pmusgrave/synth_psoc/README.md

# PSYNTH
A synthesizer using a PSoC 4 L-Series microcontroller.
