pmusgrave/synth_psoc/Hardware/Panel Artwork/path2518.png

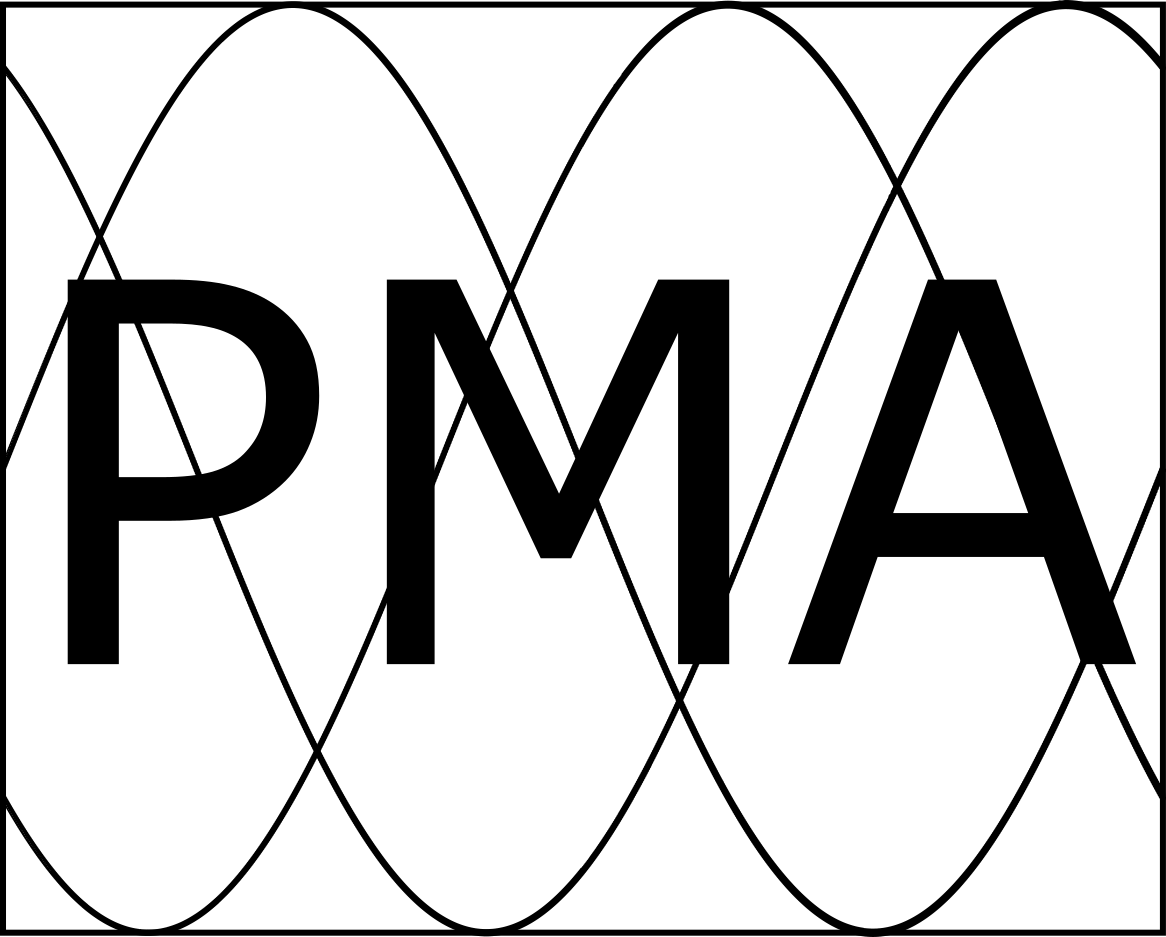
Hardware/Panel Artwork/path2518.png
