pmusgrave/synth_psoc/Hardware/Panel Artwork/Top_panel.png

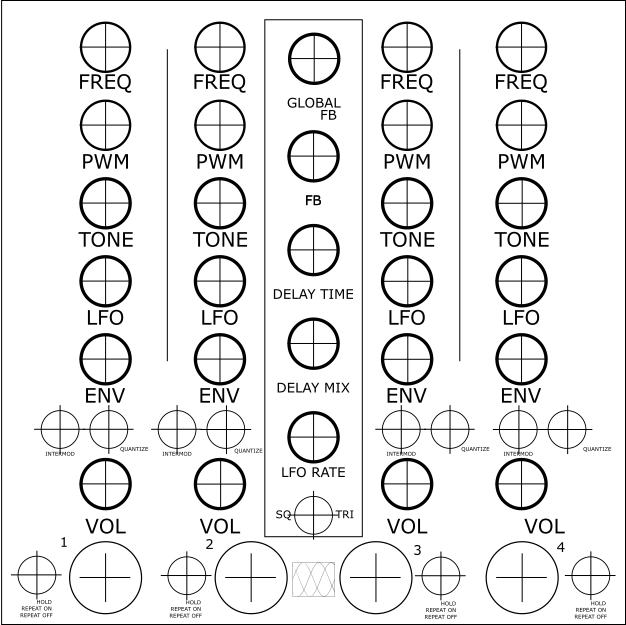
Hardware/Panel Artwork/Top_panel.png
