pmusgrave/synth_psoc/Hardware/Panel Artwork/Top_panel_2019-02-09.png

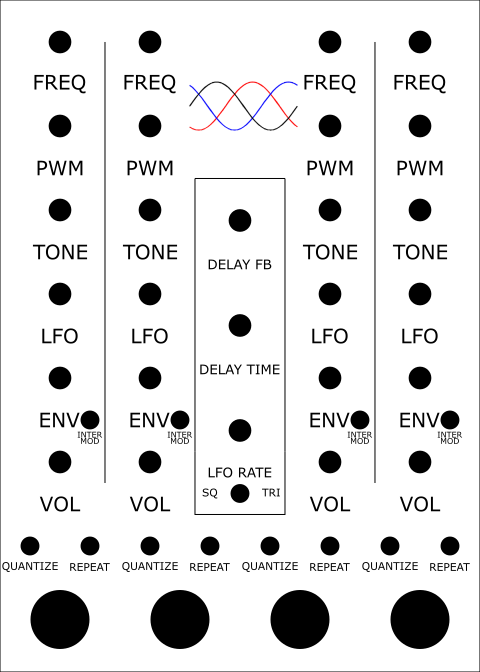
Hardware/Panel Artwork/Top_panel_2019-02-09.png
