pmusgrave/synth_psoc/Hardware/Panel Artwork/Top_panel_2019-02-20.bmp

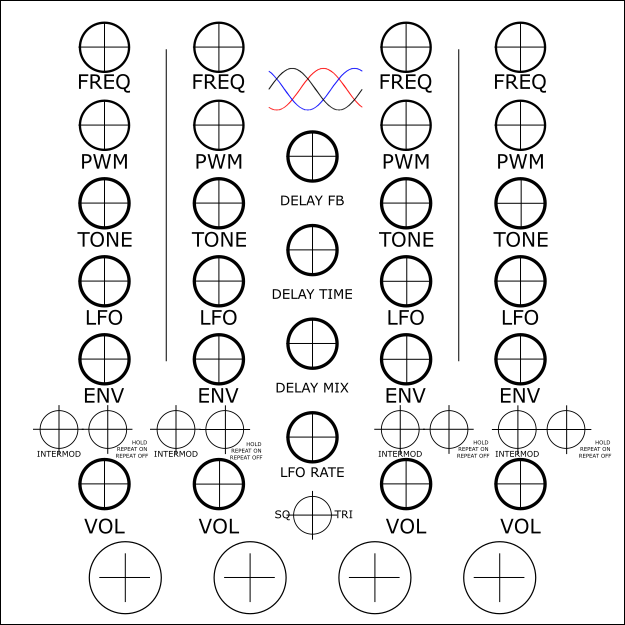
Hardware/Panel Artwork/Top_panel_2019-02-20.bmp
