pmusgrave/synth_psoc/BOM.xlsx

Item | Value | Ref Designator | Description | Manufacturer | Manufacturer P/N | Supplier | Supplier P/N | Quantity | Unit Price | Extended Price
ICs and Semiconductors
 | CY8C4246AZI-L445 | U6 | ARM Microcontrollers - MCU 32KB Flash 4KB SRAM PSoC 4 | Cypress | CY8C4246AZI-L445 | Mouser |  | 1 | $7.78 | $7.78
 | TL074 | U1 U2 U3 U4 U5 | Operational Amplifiers - Op Amps Quad Low Noise JFET | Texas Instruments | TL074CDR | Mouser |  | 5 | $0.57 | $2.85
 | NJM7805 | U7 | Linear Voltage Regulators 5V 1.5A 3 Terminal | JRC | NJM7805FA | Mouser |  | 1 | $0.75 | $0.75
 | PT2399 | U8 | Digital Delay | Princeton | PT2388 | AliExpress |  | 1 | $0.17 | $0.17
 | 4N28 | U9 | High Speed Optocouplers Darlington 100KBd Transistor Output | Lite-On | 6N138 | Mouser |  | 1 | $0.57 | $0.57
 | MMBFJ177 | Q5 Q6 Q7 Q8 | JFET P CH FET SOT-23 | ON Semiconductor | MMBFJ177 | Mouser |  | 4 | $0.40 | $1.60
 | MMBT3904-TP | Q1 Q2 Q3 Q4 Q9 | Bipolar Transistors - BJT NPN Gen Pur SS | Central Semiconductor | 2n3904 | Mouser |  | 5 | $0.40 | $2.00
 | D_Schottky | D1 | Diodes - General Purpose, Power, Switching Schottky Barrier Diode | Panasonic | DB2441700L | Mouser |  | 1 | $0.73 | $0.73
 | BZX84C3V3-T1 | D2 | Zener Diodes 3.3V | Rectron | BZX84C3V3-T1 | Mouser | 583-BZX84C3V3-T1 | 1 | $0.09 | $0.09
 | 1N914 | D3 | Rectifiers 1N914 | Rectron | TCMBD914 | Mouser | 583-TCMBD914 | 1 | $0.04 | $0.04
 |  |  |  |  |  |  |  |  |  | $0.00
 |  |  |  |  |  |  |  |  |  | $0.00
 |  |  |  |  |  |  |  |  |  | $0.00
 |  |  |  |  |  |  |  |  |  | $0.00
Passives |  |  |  |  |  |  |  |  |  | $0.00 | Subtotal | $16.58
 | 22uF | C1 C13 C14 C15 C16 C2 C3 C36 C37 C38 C39 C4 C40 C41 C42 C43 C44 C45 C46 C47 C52 C69 C72 | Aluminum Electrolytic Capacitors - SMD 22UF 35V | Nichicon | UWR1V220MCL1GB | Mouser | 647-UWR1V220MCL1GB | 23 | $0.15 | $3.45
 | 220uF | C17 C24 C25 C26 C27 C28 C29 C30 C31 C70 C71 C73 C74 C75 C76 C77 | Aluminum Electrolytic Capacitors - SMD 35volts 220uF 8x10 20% | Nichicon | UWT1V221MNL1GS | Mouser | 647-UWT1V221MNL1S | 16 | $0.26 | $4.21
 | 0.33uF | C18 | Multilayer Ceramic Capacitors MLCC - SMD/SMT 0805 0.33uF 50volts Y5V +80-20% | Vishay | VJ0805V334ZXAPW1BC | Mouser | 77-VJ0805V334ZXAPBC | 1 | $0.19 | $0.19
 | 0.1uF | C19 C49 C51 C54 C80 C81 C84 C85 C96 | Multilayer Ceramic Capacitors MLCC - SMD/SMT 50V 0.1uF Z5U 0805 -20/+80% | KEMET | C0805C104Z5UAC | Mouser | 80-C0805C104Z5UAC | 9 | $0.05 | $0.44
 | 1uF | C20 C21 C22 C23 | Aluminum Electrolytic Capacitors - SMD 50volts 1uF 4x5.4 20% | Nichicon | UWX1H010MCL1GB | Mouser | 647-UWX1H010MCL1 | 4 | $0.14 | $0.57
 | 1nF | C32 C33 C34 C35 | Multilayer Ceramic Capacitors MLCC - SMD/SMT 1000pF 50volts X7R 10% | Vishay | VJ0805Y102KXAAC | Mouser | 77-VJ0805Y102KXAAC | 4 | $0.12 | $0.48
 | 100pF | C48 C61 C62 C68 | Multilayer Ceramic Capacitors MLCC - SMD/SMT 50V 100pF C0G 0805 5% | KEMET | C0805C101J5GAC7800 | Mouser | 80-C0805C101J5G7800 | 4 | $0.06 | $0.26
 | 10nF | C10 C11 C12 C5 C6 C7 C8 C9 C64 | Multilayer Ceramic Capacitors MLCC - SMD/SMT 50V 0.01uF X7R 0805 5% | KEMET | C0805C103J5RACTU | Mouser | 80-C0805C103J5R | 9 | $0.04 | $0.33
 | 100uF | C50 | Aluminum Electrolytic Capacitors - SMD 100UF 10V | Nichicon | UWR1A101MCL1GB | Mouser | 647-UWR1A101MCL1GB | 1 | $0.19 | $0.19
 | 47uF | C53 | Aluminum Electrolytic Capacitors - SMD 4volts 47uF 4x5.4 20% | Nichicon | UWX0G470MCL1GB | Mouser | 647-UWX0G470MCL1 | 1 | $0.19 | $0.19
 | 560pF | C55 C56 | Multilayer Ceramic Capacitors MLCC - SMD/SMT 560pF 50volts C0G 5% | Vishay | VJ0805A561JXAAC | Mouser | 77-VJ0805A561JXAAC | 2 | $0.13 | $0.26
 | 82nF | C57 C58 | Multilayer Ceramic Capacitors MLCC - SMD/SMT .082uF 50volt 5% X7R | Vishay | VJ0805Y823JXACW1BC | Mouser | 77-VJ0805Y823JXATBC | 2 | $0.20 | $0.40
 | 3900pF | C59 | Multilayer Ceramic Capacitors MLCC - SMD/SMT 3900pF 50volt 5% | Vishay | VJ0805A392JXAAT | Mouser | 77-VJ0805A392JXAAT | 1 | $0.10 | $0.10
 | 3300pF | C60 | Multilayer Ceramic Capacitors MLCC - SMD/SMT 3300 pF 20% | Vishay | VJ0805Y332KXAAC | Mouser | 77-VJ0805Y332KXAAC | 1 | $0.12 | $0.12
 | 4.7uF | C63 C65 | Aluminum Electrolytic Capacitors - SMD 35volts 4.7uF 4x5.4 20% | Nichicon | UWX1V4R7MCL1GB | Mouser | 647-UWX1V4R7MCL1 | 2 | $0.19 | $0.38
 | 10uF | C66 C67 | Aluminum Electrolytic Capacitors - SMD 16volts 10uF 20% | Nichicon | UWX1C100MCL1GB | Mouser | 647-UWX1C100MCL1 | 2 | $0.19 | $0.38
 | 1uF | C78 C79 C83 C86 C88 | Aluminum Electrolytic Capacitors - SMD 50volts 1uF 4x5.4 20% | Nichicon | UWX1H010MCL1GB | Mouser | 647-UWX1H010MCL1 | 5 | $0.14 | $0.71
 | 22pF | C82 C87 C94 C95 | Multilayer Ceramic Capacitors MLCC - SMD/SMT 50V 22pF X8R 0805 10% | KEMET | C0805C220K5HACTU | Mouser | 80-C0805C220K5HACTU | 4 | $0.04 | $0.16
 | 2.2nF | C89 | Multilayer Ceramic Capacitors MLCC - SMD/SMT 50V 2200pF X7R 0805 10% | KEMET | C0805C222K5RAC7025 | Mouser | 80-C0805C222K5RACTM | 1 | $0.05 | $0.05
 | CP1_Small | C90 C91 C92 C93 |  |  |  | Mouser |  | 4 |  | $0.00
 | C_Small | C1 C10 C11 C12 C13 C14 C3 C4 C5 C6 C7 C8 C9 |  |  |  | Mouser |  | 13 |  | $0.00
 | 10uF | C2 |  |  |  | Mouser |  | 1 |  | $0.00
 | 1k | R1 R19 R2 R20 R21 R22 R3 R4 R5 R6 R7 R8 | Thick Film Resistors - SMD 0805 1Kohms 1% AEC-Q200 | Panasonic | ERJ-6ENF1001V | Mouser | 667-ERJ-6ENF1001V | 12 | $0.03 | $0.31
 | 100k | R13 R14 R15 R16 R17 R18 R72 R85 R87 | Thick Film Resistors - SMD 0805 100Kohms 1% AEC-Q200 | Panasonic | ERJ-6ENF1003V | Mouser | 667-ERJ-6ENF1003V | 9 | $0.03 | $0.23
 | 500k | R28 R30 R32 R34 |  |  |  | Mouser |  | 4 |  | $0.00
 | 22k | R35 R36 R37 R38 | Thick Film Resistors - SMD 0805 22Kohms 1% AEC-Q200 | Panasonic | ERJ-6ENF2202V | Mouser | 667-ERJ-6ENF2202V | 4 | $0.05 | $0.18
 | 1MEG | R27 R29 R31 R33 R39 R40 R41 R42 R43 R44 R45 R46 R93 R97 | Thick Film Resistors - SMD 1M 1% | Bourns | CR0805-FX-1004ELF | Mouser | 652-CR0805FX-1004ELF | 14 | $0.01 | $0.13
 | 10k | R100 R103 R51 R52 R53 R54 R56 R58 R59 R60 R63 R64 R66 R67 R68 R69 R73 R74 R75 R78 R79 R81 | Thick Film Resistors - SMD 0805 10Kohms 1% AEC-Q200 | Panasonic | ERJ-6ENF1002V | Mouser | 667-ERJ-6ENF1002V | 22 | $0.03 | $0.57
 | 4.7k | R57 R77 | Thick Film Resistors - SMD 0805 4.7Kohms 1% AEC-Q200 | Panasonic | ERJ-6ENF4701V | Mouser | 667-ERJ-6ENF4701V | 2 | $0.05 | $0.09
 | 15k | R65 R70 | Thick Film Resistors - SMD 0805 15Kohms 1% AEC-Q200 | Panasonic | ERJ-6ENF1502V | Mouser | 667-ERJ-6ENF1502V | 2 | $0.05 | $0.09
 | 5.6k | R71 | Thick Film Resistors - SMD 0805 5.6Kohms 1% AEC-Q200 | Panasonic | ERJ-6ENF5601V | Mouser | 667-ERJ-6ENF5601V | 1 | $0.05 | $0.05
 | 470R | R82 | Thick Film Resistors - SMD 470ohm 1% | Bourns | CR0805-FX-4700ELF | Mouser | 652-CR0805FX-4700ELF | 1 | $0.01 | $0.01
 | 2.2k | R83 | Thick Film Resistors - SMD 2.2K 1% | Bourns | CR0805-FX-2201ELF | Mouser | 652-CR0805FX-2201ELF | 1 | $0.01 | $0.01
 | 860R | R84 | Thick Film Resistors - SMD 0805 866ohms 1% AEC-Q200 | Panasonic | ERJ-6ENF8660V | Mouser | 667-ERJ-6ENF8660V | 1 | $0.05 | $0.05
 | 470k | R10 R11 R12 R23 R24 R25 R26 R47 R48 R49 R50 R55 R61 R62 R76 R80 R86 R88 R89 R9 R90 R91 | Thick Film Resistors - SMD 0805 470Kohms 1% AEC-Q200 | Panasonic | ERJ-6ENF4703V | Mouser | 667-ERJ-6ENF4703V | 22 | $0.03 | $0.57
 | R | R111 R112 R113 R114 R92 R94 |  |  |  | Mouser |  | 6 |  | $0.00
 | 0R | R95 R96 |  |  |  | Mouser |  | 2 |  | $0.00
 | 220R | R101 R102 R98 | Thick Film Resistors - SMD 220ohm 1% | Bourns | CR0805-FX-2200ELF | Mouser | 652-CR0805FX-2200ELF | 3 | $0.01 | $0.03
 | 280R | R99 | Thick Film Resistors - SMD 0805 280ohms 1% AEC-Q200 | Panasonic | ERJ-6ENF2800V | Mouser | 667-ERJ-6ENF2800V | 1 | $0.03 | $0.03
 | POT_TRIM | RV5 RV6 RV7 RV8 | Trimmer Resistors - SMD 3MM 10KOHMS 25% 0.1WATT OPEN FRM | Bourns | TC33X-2-103E | Mouser | 652-TC33X-2-103E | 4 | $0.21 | $0.82
 | R | R1 R10 R11 R12 R13 R14 R15 R16 R17 R18 R19 R2 R20 R21 R22 R23 R24 R25 R3 R4 R5 R6 R7 R8 R9 |  |  |  | Mouser |  | 25 |  | $0.00
 | 20kA | RV1 RV2 RV27 RV3 RV4 RV6 RV7 RV8 RV9 | Potentiometers 20K AUDIO 20% | Bourns | PTV09A-4025F-A203 | Mouser | 652-PTV09A-4025FA203 | 9 | $0.67 | $6.05
 | 20kB | RV10 RV11 RV12 RV13 | Potentiometers 10K LINEAR 20% | Bourns | PTV09A-4025F-B103 | Mouser | 652-PTV09A-4025FB103 | 4 | $0.67 | $2.68
 | POT_DUAL | RV14 RV15 RV16 RV17 | Potentiometers 12MM V/ADJ | ALPS | RK12L12C0A0A | Mouser | 688-RK12L12C0A0A | 4 | $0.70 | $2.80
 | 100kA | RV18 RV19 RV20 RV21 RV22 RV23 RV24 RV25 | Potentiometers 25mm Ins. Kn. Shaft 100,000 Ohms | Bourns | PTV09A-4025U-A104 | Mouser | 652-PTV09A-4025UA104 | 8 | $0.63 | $5.07
 | 50kA | RV26 | Potentiometers 50K AUDIO 20% | Bourns | PTV09A-4225F-A503 | Mouser | 652-PTV09A-4225FA503 | 1 | $0.74 | $0.74
 | 50k | RV28 | ??? |  |  | Mouser |  | 1 |  | $0.00
 | 10kA | RV29 RV5 |  |  |  | Mouser |  | 2 |  | $0.00
 | 16MHz | Y1 | Crystal, 16MHz |  |  | Mouser |  | 1 |  | $0.00
 | 32.768kHz | Y2 | Crystal, 32.768kHz |  |  | Mouser |  | 1 | $0.38 | $0.38
 |  |  |  |  |  |  |  |  |  | $0.00 | Subtotal | $33.76
Mechanical |  |  |  |  |  |  |  |  |  | $0.00
 | ~~-~~ | ~~-~~ | ~~Chassis - Steel 7" x 5" x 2"~~ | ~~Hammond~~ | ~~1441-12BK3~~ | ~~Mouser~~ | ~~546-1441-12BK3~~ | 0 | $13.24 | $0.00
 | ~~-~~ | ~~-~~ | ~~Bottom Plate 7 x 5" 20AWG Steel Black~~ | ~~Hammond~~ | ~~1431-12BK3~~ | ~~Mouser~~ | ~~546-1431-12BK3~~ | 0 | $4.82 | $0.00
 | ~~-~~ | ~~-~~ | Enclosures, Boxes, & Cases Diecast Alum Black 7.38 x 7.38 x 2.48" | Hammond | 1590FBK | Mouser | 546-1590F-BK | 1 | $31.15 | $31.15
 | - | - | Knobs |  |  | AliExpress |  | 29 | $0.39 | $11.31
 | - | - | Toggle Switches SPST ON-OFF-ON |  |  | AliExpress |  | 4 | $0.18 | $0.72
 | - | - | Toggle Switches SPDT ON-ON |  |  | AliExpress |  | 9 | $0.19 | $1.71
 | - | - | PCB, Control Board | JLCPCB |  | JLCPCB |  | 1 | $35.79 | $35.79
 | - | - | PCB, Main Synth Board | JLCPCB |  | JLCPCB |  | 1 | $35.79 | $35.79
 | power | J1 | Headers & Wire Housings 2 POS HEADER | Molex | 22-27-2021 | Mouser | 538-22-27-2021 | 1 | $0.27 | $0.27
 | power | J1 | Headers & Wire Housings CRIMP TERM 22-30 TIN | Molex | 08-50-0114 | Mouser | 538-08-50-0114 | 2 | $0.18 | $0.36
 | power | J1 | Headers & Wire Housings HSG 2P W/RAMP/RIBS | Molex | 22-01-3027 | Mouser | 538-22-01-3027 | 1 | $0.14 | $0.14
 | USB-Cable | J7 | Headers & Wire Housings 4P PIN SIL FEMALE HOUSING | Harwin | M22-3070400 | Mouser | 855-M22-3070400 | 2 | $0.11 | $0.22
 | USB-Board | J7 | Headers & Wire Housings 4 SIL SHRD PIN HDR TIN VERTICAL | Harwin | M22-2200446 | Mouser | 855-M22-2200446 | 2 | $0.24 | $0.48
 | USB-crimp | J7 | Headers & Wire Housings 2MM F/M CRIMP CNTCT 24-30AWG TIN | Harwin | M22-3050046 | Mouser | 855-M22-3050046 | 4 | $0.19 | $0.76
 | USB | J10 | USB Connectors Vertical Plug 2row SMT | JAE Electronics | DX07VN24WA2C1568 | Mouser | 656-DX07VN24WA2C1568 | 1 | $2.38 | $2.38
 | MIDI | J11 | Headers & Wire Housings 02 SIL VERTICAL PIN HEADER TIN | Harwin | M20-9990246 | Mouser | 855-M20-9990246 | 2 | $0.10 | $0.20
 | MIDI Mating connector | J11 | Headers & Wire Housings 2 PIN SIL VERTICAL SOCKET TIN | Harwin | M20-7820246 | Mouser | 855-M20-7820246 | 2 | $0.71 | $1.42
 | Conn_01x05 | J13 J14 J15 J16 | Headers & Wire Housings 5 PIN SIL VERTICAL SOCKET TIN | Harwin | M20-7820546 | Mouser | 855-M20-7820546 | 4 |  | $0.00
 | Audio-Jack-2_Switch | J2 |  |  |  | Mouser |  | 1 |  | $0.00
 | SWD_programming | J3 |  |  |  | Mouser |  | 1 |  | $0.00
 | Conn_01x08 | J4 J5 J11 J4 | Headers & Wire Housings 08 SIL VERTICAL PIN HEADER TIN | Harwin | M20-9990846 | Mouser |  | 4 | $0.29 | $1.16
 | Conn_01x08 | J4 J5 J11 J4 | Headers & Wire Housings | Preci-dip | 310-87-108-41-001101 | Mouser |  | 4 | $0.50 | $2.00
 | Conn_01x03 | J2 J6 | Headers & Wire Housings 03 MODII HDR SRST B/A 100 W/HD | TE Connectivity | 5-146293-3 | Mouser |  | 2 | $0.50 | $1.00
 | Conn_01x03 | J2 J6 | Headers & Wire Housings | Preci-dip | 310-87-103-41-001101 | Mouser |  | 2 | $0.29 | $0.58
 | Conn_02x13_Odd_Even | J1 J3 J8 J9 | Headers & Wire Housings 2X13POS HDR TIN | Amphenol FCI | 67997-426HLF | Mouser |  | 4 |  | $0.00
 | Conn_02x13_Odd_Even | J1 J3 J8 J9 | Headers & Wire Housings 13+13 DIL VERTICAL SOCKET TIN | Harwin | M20-7831346 | Mouser |  | 4 | $2.36 | $9.44
 | DC IN | - | DC Power Connectors DC SOCKET 2.35MM CHASSIS MOUNT | Schurter | 4840.221 | Mouser | 693-4840.221 | 1 | $1.73 | $1.73
 | Conn_01x05 | J10 J7 J8 J9 |  |  |  |  |  | 4 |  | $0.00
 | MIDI Panel Connectors |  | DIN Connectors 5 PIN DIN PANEL MNT | Kobiconn | 161-0005-E | Mouser |  | 2 | $1.65 | $3.30 | Subtotal | $141.91
 |  |  |  |  |  |  |  |  | TOTAL: | $192.25
 |  |  |  |  |  |  |  | U1 U2 U3 U4 U5 | 5 | TL074
 |  |  |  |  |  |  |  | U6 | 1 | CY8C4246AZI-L445
 |  |  |  |  |  |  |  | U7 | 1 | V7805-1000
 |  |  |  |  |  |  |  | U8 | 1 | PT2399
 |  |  |  |  |  |  |  | U9 | 1 | 4N28
 |  |  |  |  |  |  |  | Y1 | 1 | 16MHz
 |  |  |  |  |  |  |  | Y2 | 1 | 32.768kHz
