pmusgrave/synth_psoc/profitability.xlsx

Unit Sales | Profit Per Sale Required to reach target | Target Gross Income | Scenarios | $100.00 | $150.00 | $200.00 | $250.00 | $300.00 | $350.00 | $400.00 | $450.00 | $500.00
1 | $50000.00 | $50000.00 | Profit Per Sale | $100.00 | $150.00 | $200.00 | $250.00 | $300.00 | $350.00 | $400.00 | $450.00 | $500.00
5 | $10000.00 |  | $100.00 | $500.00 | $750.00 | $1000.00 | $1250.00 | $1500.00 | $1750.00 | $2000.00 | $2250.00 | $2500.00
10 | $5000.00 |  | $150.00 | $1000.00 | $1500.00 | $2000.00 | $2500.00 | $3000.00 | $3500.00 | $4000.00 | $4500.00 | $5000.00
15 | $3333.33 |  | $200.00 | $1500.00 | $2250.00 | $3000.00 | $3750.00 | $4500.00 | $5250.00 | $6000.00 | $6750.00 | $7500.00
20 | $2500.00 |  | $250.00 | $2000.00 | $3000.00 | $4000.00 | $5000.00 | $6000.00 | $7000.00 | $8000.00 | $9000.00 | $10000.00
30 | $1666.67 |  | $300.00 | $3000.00 | $4500.00 | $6000.00 | $7500.00 | $9000.00 | $10500.00 | $12000.00 | $13500.00 | $15000.00
40 | $1250.00 |  | $350.00 | $4000.00 | $6000.00 | $8000.00 | $10000.00 | $12000.00 | $14000.00 | $16000.00 | $18000.00 | $20000.00
50 | $1000.00 |  | $400.00 | $5000.00 | $7500.00 | $10000.00 | $12500.00 | $15000.00 | $17500.00 | $20000.00 | $22500.00 | $25000.00
100 | $500.00 |  | $450.00 | $10000.00 | $15000.00 | $20000.00 | $25000.00 | $30000.00 | $35000.00 | $40000.00 | $45000.00 | $50000.00
150 | $333.33 |  | $500.00 | $15000.00 | $22500.00 | $30000.00 | $37500.00 | $45000.00 | $52500.00 | $60000.00 | $67500.00 | $75000.00
200 | $250.00 |  |  | $20000.00 | $30000.00 | $40000.00 | $50000.00 | $60000.00 | $70000.00 | $80000.00 | $90000.00 | $100000.00
250 | $200.00 |  |  | $25000.00 | $37500.00 | $50000.00 | $62500.00 | $75000.00 | $87500.00 | $100000.00 | $112500.00 | $125000.00
300 | $166.67 |  |  | $30000.00 | $45000.00 | $60000.00 | $75000.00 | $90000.00 | $105000.00 | $120000.00 | $135000.00 | $150000.00
350 | $142.86 |  |  | $35000.00 | $52500.00 | $70000.00 | $87500.00 | $105000.00 | $122500.00 | $140000.00 | $157500.00 | $175000.00
400 | $125.00 |  |  | $40000.00 | $60000.00 | $80000.00 | $100000.00 | $120000.00 | $140000.00 | $160000.00 | $180000.00 | $200000.00
450 | $111.11 |  |  | $45000.00 | $67500.00 | $90000.00 | $112500.00 | $135000.00 | $157500.00 | $180000.00 | $202500.00 | $225000.00
500 | $100.00 |  |  | $50000.00 | $75000.00 | $100000.00 | $125000.00 | $150000.00 | $175000.00 | $200000.00 | $225000.00 | $250000.00
550 | $90.91 |  |  | $55000.00 | $82500.00 | $110000.00 | $137500.00 | $165000.00 | $192500.00 | $220000.00 | $247500.00 | $275000.00
600 | $83.33 |  |  | $60000.00 | $90000.00 | $120000.00 | $150000.00 | $180000.00 | $210000.00 | $240000.00 | $270000.00 | $300000.00
650 | $76.92 |  |  | $65000.00 | $97500.00 | $130000.00 | $162500.00 | $195000.00 | $227500.00 | $260000.00 | $292500.00 | $325000.00
700 | $71.43 |  |  | $70000.00 | $105000.00 | $140000.00 | $175000.00 | $210000.00 | $245000.00 | $280000.00 | $315000.00 | $350000.00
750 | $66.67 |  |  | $75000.00 | $112500.00 | $150000.00 | $187500.00 | $225000.00 | $262500.00 | $300000.00 | $337500.00 | $375000.00
800 | $62.50 |  |  | $80000.00 | $120000.00 | $160000.00 | $200000.00 | $240000.00 | $280000.00 | $320000.00 | $360000.00 | $400000.00
850 | $58.82 |  |  | $85000.00 | $127500.00 | $170000.00 | $212500.00 | $255000.00 | $297500.00 | $340000.00 | $382500.00 | $425000.00
900 | $55.56 |  |  | $90000.00 | $135000.00 | $180000.00 | $225000.00 | $270000.00 | $315000.00 | $360000.00 | $405000.00 | $450000.00
950 | $52.63 |  |  | $95000.00 | $142500.00 | $190000.00 | $237500.00 | $285000.00 | $332500.00 | $380000.00 | $427500.00 | $475000.00
1000 | $50.00 |  |  | $100000.00 | $150000.00 | $200000.00 | $250000.00 | $300000.00 | $350000.00 | $400000.00 | $450000.00 | $500000.00
