pmusgrave/synth_psoc/Simulation/P-Channel JFET VGA for envelope generator.asc

C1: cap; 220µ
C2: cap; 220µ
C3: cap; 220µ
J1: pjf; LSJ689B
Q1: npn
R1: res; 100k
R2: res; 10k
R3: res; 1Meg
R4: res; 10k
R5: res; 100k
R6: res; 1Meg
R7: res; 470k
U1: AD795
V1: voltage; PULSE(0 3.3 0 0 0 .001 .002)
V2: voltage; SINE(0 2 5)
V3: voltage; 15
V4: voltage; 15
V5: voltage; 2
V6: voltage; 5
Named nets: 0, 15, -15
.tran 0 1 0 .01
