pmusgrave/synth_psoc/Simulation/bias buffer.asc

C1: cap; 1µ
Q1: npn
R1: res; 47k
R2: res; 15k
R3: res; 1k
V1: voltage; 15
Named nets: 0
.tran 0 0.1 0 0.01
