pmusgrave/synth_psoc/Simulation/LPF.asc

C1: cap; 22µ
C2: cap; 1µ
C3: cap; 22µ
C4: cap; 10n
C5: cap; 22µ
C6: cap; 22µ
C7: cap; 10n
R1: res; 470k
R2: res; 100k
R3: res; 1k
R4: res; 100k
R5: res; 100k
R6: res; 1k
R7: res; 100k
R8: res; 470k
R9: res; 1k
U1: AD795
U2: AD795
V1: voltage; PULSE(0 3.3 0 0 0 0.0001 0.0002); AC 1
V3: voltage; 15
V4: voltage; 15
V5: voltage; PULSE(0 3.3 0 0 0 0.0001 0.0002); AC 1
Named nets: 0, +15V, -15V, VREF
.ac oct 10 1 20k
