pmusgrave/synth_psoc/Simulation/LFO.asc

C1: cap; 22µ
C2: cap; 22µ
C3: cap; 22µ
C4: cap; 1µ
C5: cap; 220µ
D1: zener; 1N750
R1: res; 10k
R2: res; 100k
R3: res; 50k
R4: res; 10k
R5: res; 100k
R6: res; 10k
R7: res; 10k
R8: res; 2.2k
R9: res; 470k
R10: res; 470k
R11: res; 100k
R12: res; 470
R13: res; 860
R15: res; 100k
U1: AD795
U2: AD795
U3: AD795
V3: voltage; 15
V4: voltage; 15
Named nets: 0, +15V, -15V, VREF
.tran 0 0.25 0 0.01
