pmusgrave/synth_psoc/Simulation/summing mixer.asc

C1: cap; 22µ
C2: cap; 100p
C3: cap; 22µ
R1: res; 470k
R2: res; 100k
R3: res; 10k
R4: res; 100k
R5: res; 100k
R6: res; 10k
U2: AD795
V3: voltage; 15
V4: voltage; 15
V5: voltage; PULSE(0 3.3 0 0 0 0.0001 0.0002); AC 1
Named nets: 0, +15V, -15V, VREF
.ac oct 10 1 20k
