pmusgrave/synth_psoc/Simulation/arbitrary phase shifter.asc

C1: cap; 10µ
C2: cap; 33n
Q1: npn
R1: res; 10k
R2: res; 10k
R3: res; 47k
R4: res; 22k
R5: res; 10k
V1: voltage; SINE(0 3 100); AC 1
V2: voltage; 15
Named nets: 0, +v
.ac oct 10 10 20k
