pmusgrave/synth_psoc/Simulation/P-Channel JFET compressor.asc

C1: cap; 220µ
J1: pjf
R1: res; 22k
R2: res; 10k
R3: res; 1Meg
R4: res; 10k
R5: res; 100k
U1: AD795
V1: voltage; PULSE(0 3.3 0 0 0 .001 .002)
V2: voltage; PULSE(0 3.3 0 .3 0 .1 .2)
V3: voltage; 15
V4: voltage; 15
Named nets: 0, 15, -15
.tran 0 1 0 .01
