pmusgrave/synth_psoc/Simulation/PWM_filtering.asc

C1: cap; 220µ
C2: cap; 1µ
C3: cap; 220µ
R1: res; 470k
R2: res; 100k
R3: res; 1k
R4: res; 100k
R5: res; 100k
U2: AD795
V3: voltage; 15
V4: voltage; 15
V5: voltage; PULSE(0 3.3 0 0 0 0.0001 0.0002)
Named nets: 0, +15V, -15V, VREF
.tran 0 .1 0 0.01
