pmusgrave/synth_psoc/Hardware/Synth_Control_Board/control_board.kicad_pcb

## KiCad design Hardware/Synth_Control_Board/control_board.kicad_pcb (2019-03-28)

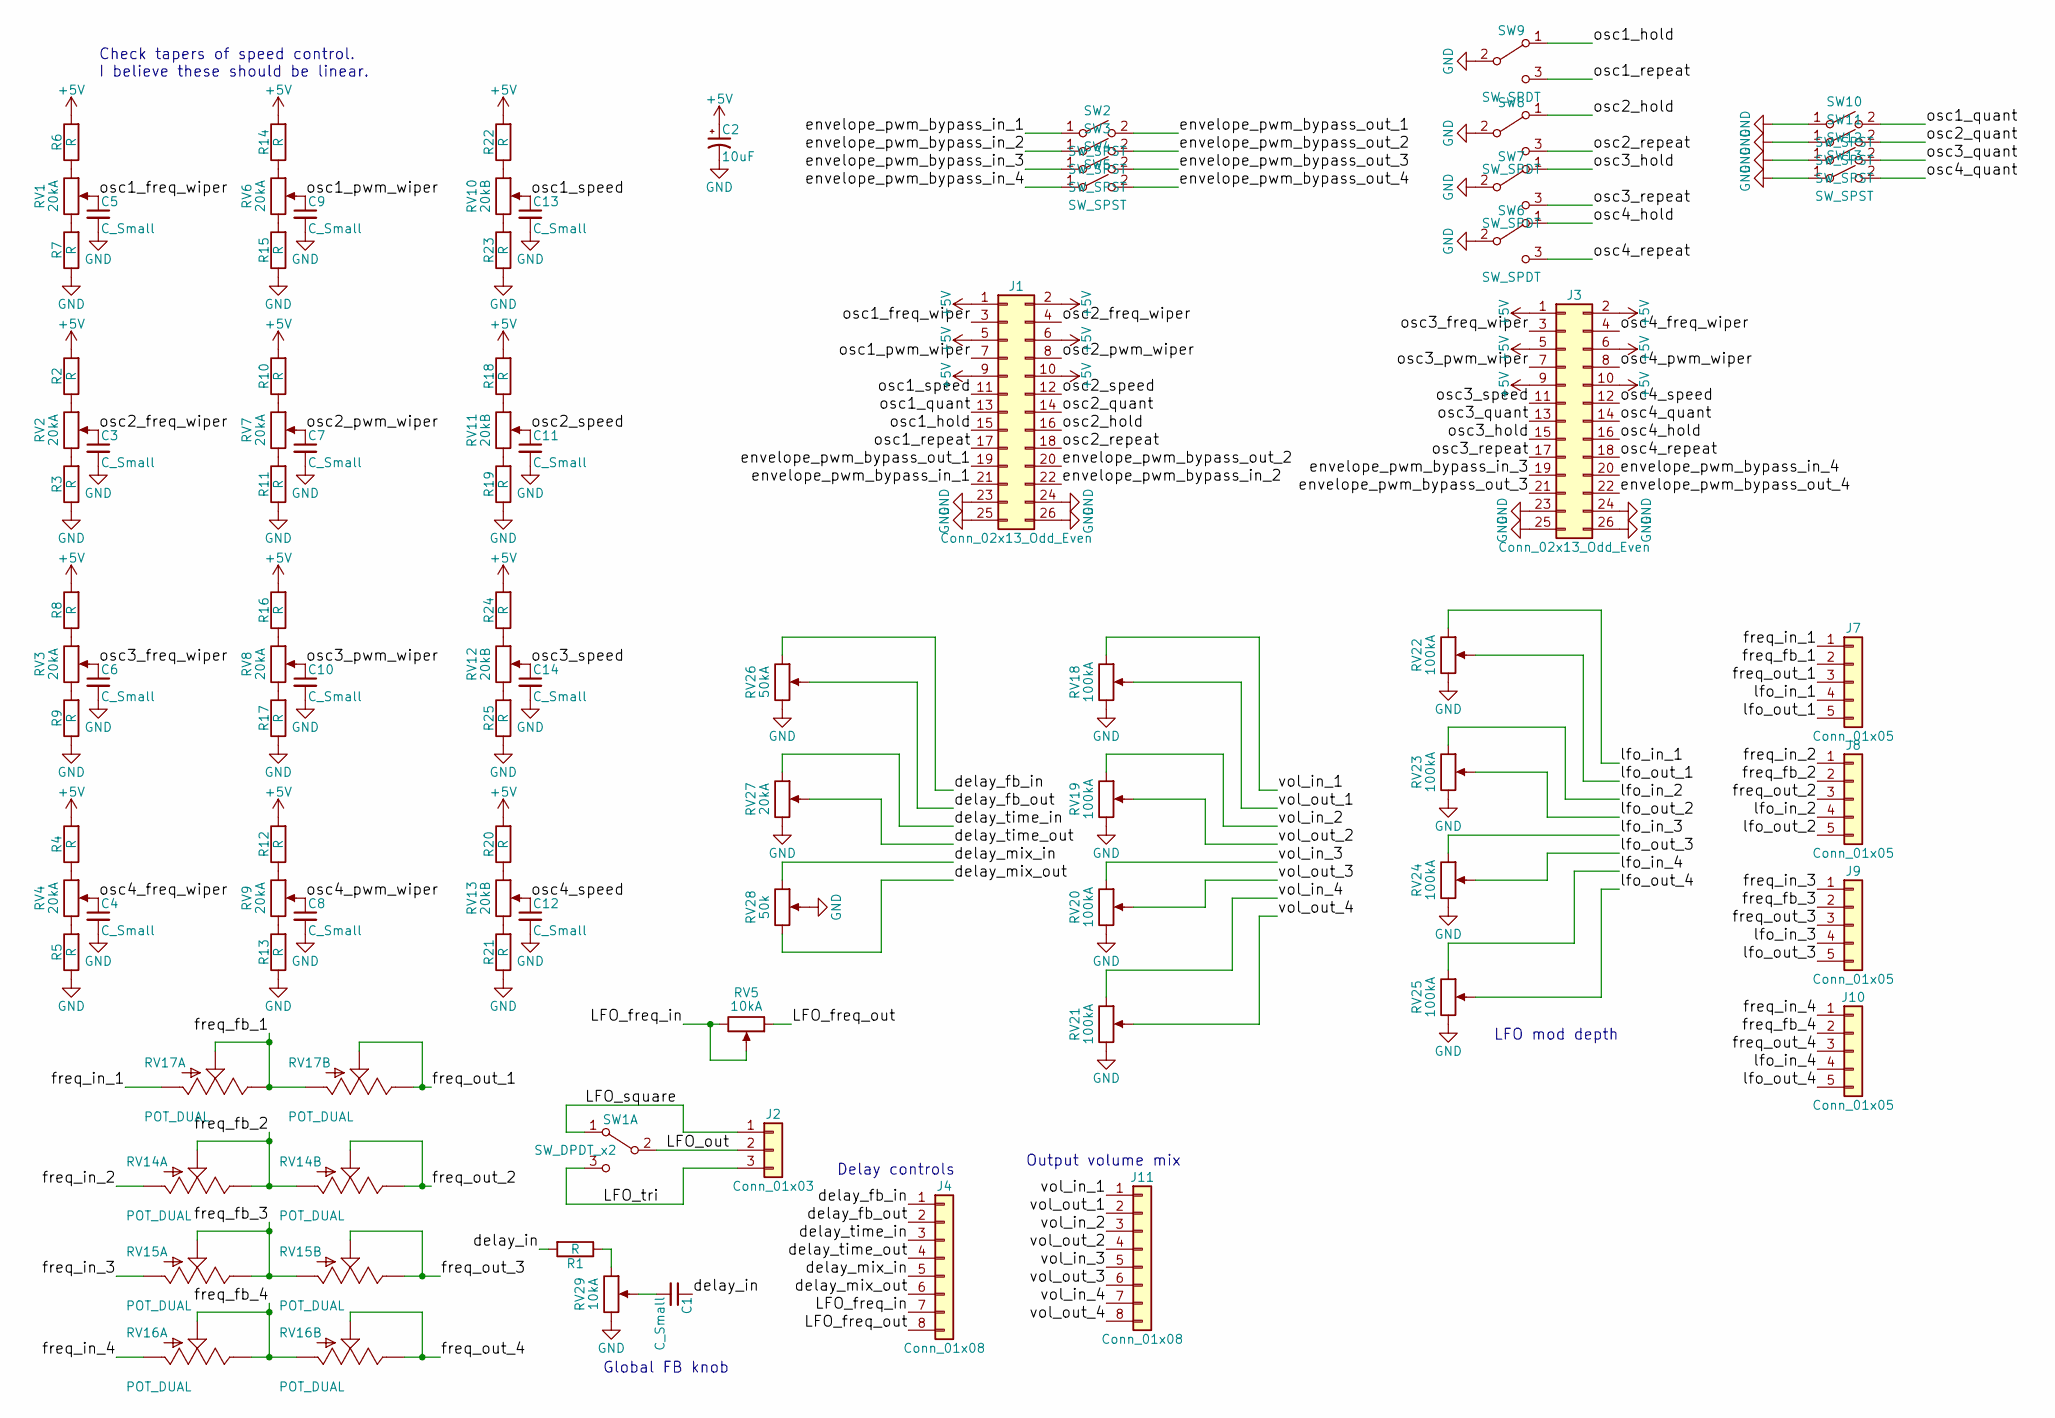
[picture p13: schematic control_board.sch]

Parts:
C1, C3, C4, C5, C6, C7, C8, C9, C10, C11, C12, C13, C14: C_Small; 0805
C2: 10uF; CP_Radial_D8.0mm_P5.00mm
J1, J3: Conn_02x13_Odd_Even; Pin_Header_Straight_2x13_Pitch2.54mm
J2: Conn_01x03; Pin_Header_Straight_1x03_Pitch2.54mm
J4, J11: Conn_01x08; Pin_Header_Straight_1x08_Pitch2.54mm
J7, J8, J9, J10: Conn_01x05; Pin_Header_Straight_1x05_Pitch2.54mm
R1, R2, R3, R4, R5, R6, R7, R8, R9, R10, R11, R12, R13, R14, R15, R16, R17, R18, R19, R20, R21, R22, R23, R24, R25: R; 0805
RV1, RV2, RV3, RV4, RV6, RV7, RV8, RV9, RV27: 20kA; Potentiometer_Bourns_PTV09A-1_Horizontal
RV5, RV29: 10kA; Potentiometer_Bourns_PTV09A-1_Horizontal
RV10, RV11, RV12, RV13: 20kB; Potentiometer_Bourns_PTV09A-1_Horizontal
RV14, RV15, RV16, RV17: POT_DUAL; POT_PANASONIC_DUAL_VERT_KIT
RV18, RV19, RV20, RV21, RV22, RV23, RV24, RV25: 100kA; Potentiometer_Bourns_PTV09A-1_Horizontal
RV26: 50kA; Potentiometer_Bourns_PTV09A-1_Horizontal
RV28: 50k; Potentiometer_Bourns_PTV09A-1_Horizontal
SW1: SW_DPDT_x2; switch_toggle_4.7mm_pitch
SW2, SW3, SW4, SW5, SW10, SW11, SW12, SW13: SW_SPST; switch_toggle_4.7mm_pitch
SW6, SW7, SW8, SW9: SW_SPDT; switch_toggle_4.7mm_pitch

Connections:
+5V: C2.1, J1.1, J1.2, J1.5, J1.6, J1.9, J1.10, J3.1, J3.2, J3.5, J3.6, J3.9, J3.10, R2.2, R4.2, R6.2, R8.2, R10.2, R12.2, R14.2, R16.2, R18.2, R20.2, R22.2, R24.2
/LFO_freq_in: J4.7, RV5.2, RV5.3
/LFO_freq_out: J4.8, RV5.1
/LFO_out: J2.2, SW1.2 (B)
/LFO_square: J2.1, SW1.1 (A)
/LFO_tri: J2.3, SW1.3 (C)
/delay_fb_in: J4.1, RV26.1
/delay_fb_out: J4.2, RV26.2
/delay_in: C1.1, R1.2
/delay_mix_in: J4.5, RV28.1
/delay_mix_out: J4.6, RV28.3
/delay_time_in: J4.3, RV27.1
/delay_time_out: J4.4, RV27.2
/envelope_pwm_bypass_in_1: J1.21, SW2.1 (A)
/envelope_pwm_bypass_in_2: J1.22, SW3.1 (A)
/envelope_pwm_bypass_in_3: J3.19, SW4.1 (A)
/envelope_pwm_bypass_in_4: J3.20, SW5.1 (A)
/envelope_pwm_bypass_out_1: J1.19, SW2.2 (B)
/envelope_pwm_bypass_out_2: J1.20, SW3.2 (B)
/envelope_pwm_bypass_out_3: J3.21, SW4.2 (B)
/envelope_pwm_bypass_out_4: J3.22, SW5.2 (B)
/freq_fb_1: J7.2, RV17.A1 (E), RV17.A2 (S), RV17.B3 (A)
/freq_fb_2: J8.2, RV14.A1 (E), RV14.A2 (S), RV14.B3 (A)
/freq_fb_3: J9.2, RV15.A1 (E), RV15.A2 (S), RV15.B3 (A)
/freq_fb_4: J10.2, RV16.A1 (E), RV16.A2 (S), RV16.B3 (A)
/freq_in_1: J7.1, RV17.A3 (A)
/freq_in_2: J8.1, RV14.A3 (A)
/freq_in_3: J9.1, RV15.A3 (A)
/freq_in_4: J10.1, RV16.A3 (A)
/freq_out_1: J7.3, RV17.B1 (E), RV17.B2 (S)
/freq_out_2: J8.3, RV14.B1 (E), RV14.B2 (S)
/freq_out_3: J9.3, RV15.B1 (E), RV15.B2 (S)
/freq_out_4: J10.3, RV16.B1 (E), RV16.B2 (S)
/lfo_in_1: J7.4, RV22.1
/lfo_in_2: J8.4, RV23.1
/lfo_in_3: J9.4, RV24.1
/lfo_in_4: J10.4, RV25.1
/lfo_out_1: J7.5, RV22.2
/lfo_out_2: J8.5, RV23.2
/lfo_out_3: J9.5, RV24.2
/lfo_out_4: J10.5, RV25.2
/osc1_freq_wiper: C5.1, J1.3, RV1.2
/osc1_hold: J1.15, SW9.1 (A)
/osc1_pwm_wiper: C9.1, J1.7, RV6.2
/osc1_quant: J1.13, SW10.2 (B)
/osc1_repeat: J1.17, SW9.3 (C)
/osc1_speed: C13.1, J1.11, RV10.2
/osc2_freq_wiper: C3.1, J1.4, RV2.2
/osc2_hold: J1.16, SW8.1 (A)
/osc2_pwm_wiper: C7.1, J1.8, RV7.2
/osc2_quant: J1.14, SW11.2 (B)
/osc2_repeat: J1.18, SW8.3 (C)
/osc2_speed: C11.1, J1.12, RV11.2
/osc3_freq_wiper: C6.1, J3.3, RV3.2
/osc3_hold: J3.15, SW7.1 (A)
/osc3_pwm_wiper: C10.1, J3.7, RV8.2
/osc3_quant: J3.13, SW12.2 (B)
/osc3_repeat: J3.17, SW7.3 (C)
/osc3_speed: C14.1, J3.11, RV12.2
/osc4_freq_wiper: C4.1, J3.4, RV4.2
/osc4_hold: J3.16, SW6.1 (A)
/osc4_pwm_wiper: C8.1, J3.8, RV9.2
/osc4_quant: J3.14, SW13.2 (B)
/osc4_repeat: J3.18, SW6.3 (C)
/osc4_speed: C12.1, J3.12, RV13.2
/vol_in_1: J11.1, RV18.1
/vol_in_2: J11.3, RV19.1
/vol_in_3: J11.5, RV20.1
/vol_in_4: J11.7, RV21.1
/vol_out_1: J11.2, RV18.2
/vol_out_2: J11.4, RV19.2
/vol_out_3: J11.6, RV20.2
/vol_out_4: J11.8, RV21.2
GND: C2.2, C3.2, C4.2, C5.2, C6.2, C7.2, C8.2, C9.2, C10.2, C11.2, C12.2, C13.2, C14.2, J1.23, J1.24, J1.25, J1.26, J3.23, J3.24, J3.25, J3.26, R3.1, R5.1, R7.1, R9.1, R11.1, R13.1, R15.1, R17.1, R19.1, R21.1, R23.1, R25.1, RV18.3, RV19.3, RV20.3, RV21.3, RV22.3, RV23.3, RV24.3, RV25.3, RV26.3, RV27.3, RV28.2, RV29.3, SW6.2 (B), SW7.2 (B), SW8.2 (B), SW9.2 (B), SW10.1 (A), SW11.1 (A), SW12.1 (A), SW13.1 (A)
unnamed: C1.2, RV29.2
unnamed: R1.1, RV29.1
unnamed: R2.1, RV2.1
unnamed: R3.2, RV2.3
unnamed: R4.1, RV4.1
unnamed: R5.2, RV4.3
unnamed: R6.1, RV1.1
unnamed: R7.2, RV1.3
unnamed: R8.1, RV3.1
unnamed: R9.2, RV3.3
unnamed: R10.1, RV7.1
unnamed: R11.2, RV7.3
unnamed: R12.1, RV9.1
unnamed: R13.2, RV9.3
unnamed: R14.1, RV6.1
unnamed: R15.2, RV6.3
unnamed: R16.1, RV8.1
unnamed: R17.2, RV8.3
unnamed: R18.1, RV11.1
unnamed: R19.2, RV11.3
unnamed: R20.1, RV13.1
unnamed: R21.2, RV13.3
unnamed: R22.1, RV10.1
unnamed: R23.2, RV10.3
unnamed: R24.1, RV12.1
unnamed: R25.2, RV12.3

Notes on the sheet:
Check tapers of speed control. I believe these should be linear.
Output volume mix
LFO mod depth
Delay controls
Global FB knob

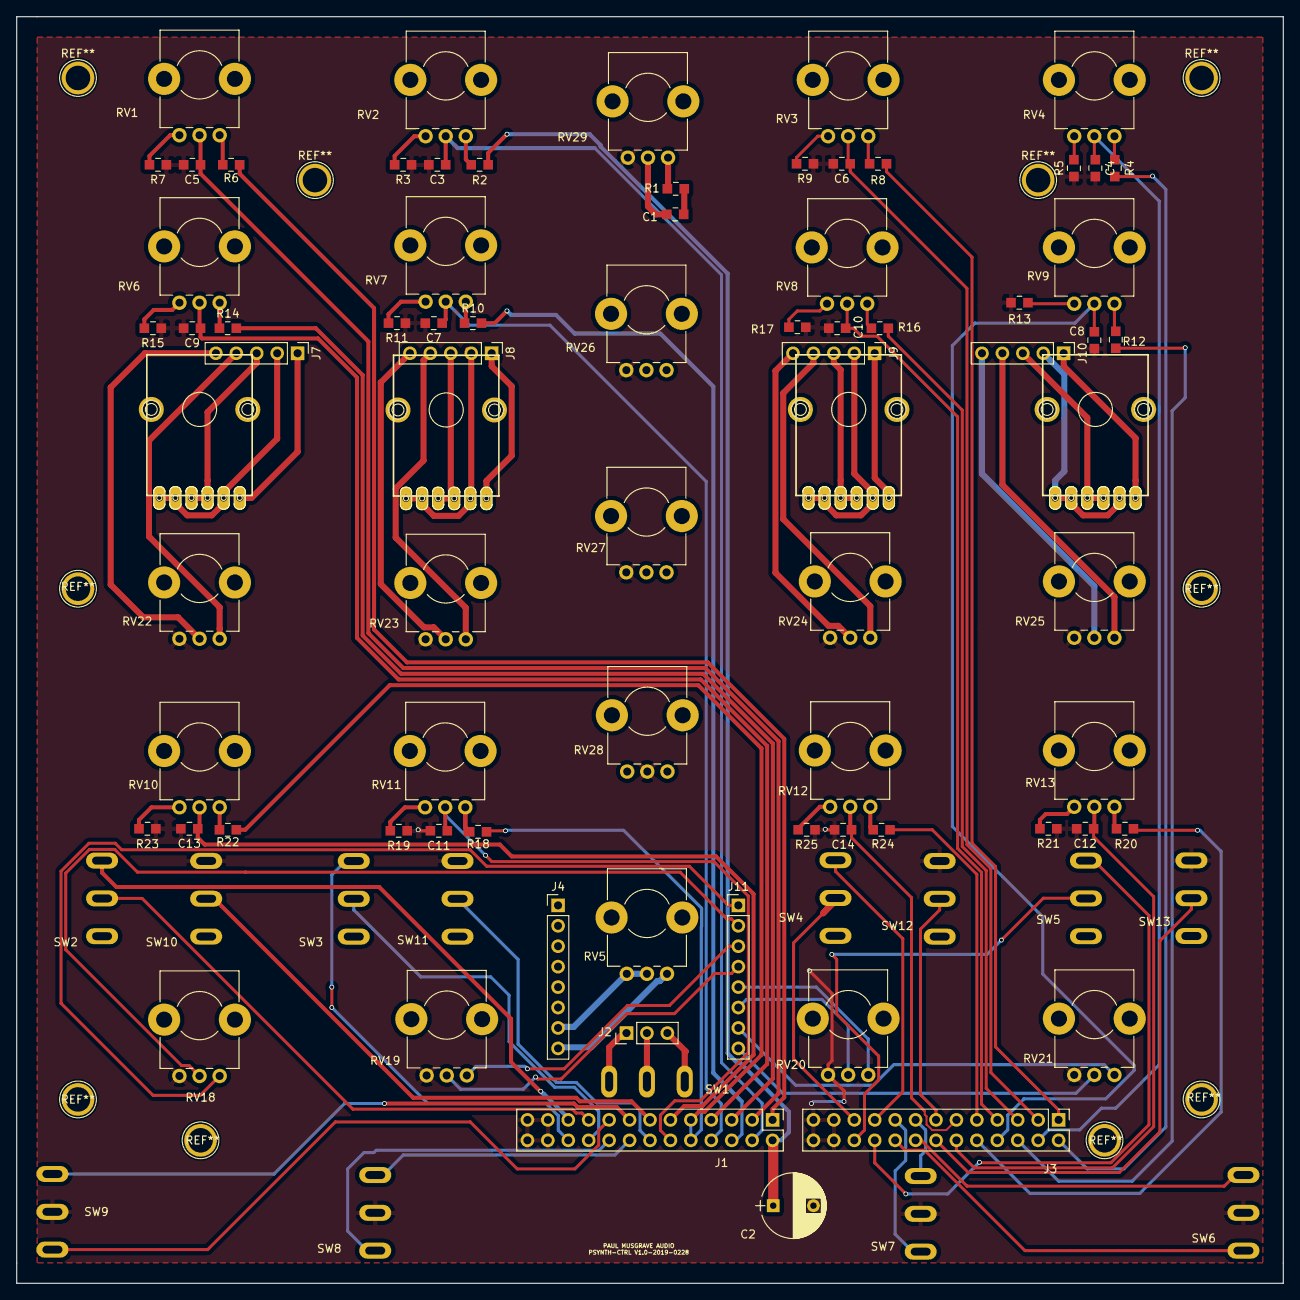
[picture p14: board control_board.kicad_pcb from above]

Board: 2 copper layers, 157.5 x 157.5 mm, 90 parts (0 on the bottom side), 100 nets.
