pmusgrave/synth_psoc/Hardware/Synth_Engine/synth_psoc.kicad_pcb

## KiCad design Hardware/Synth_Engine/synth_psoc.kicad_pcb (2019-03-01)

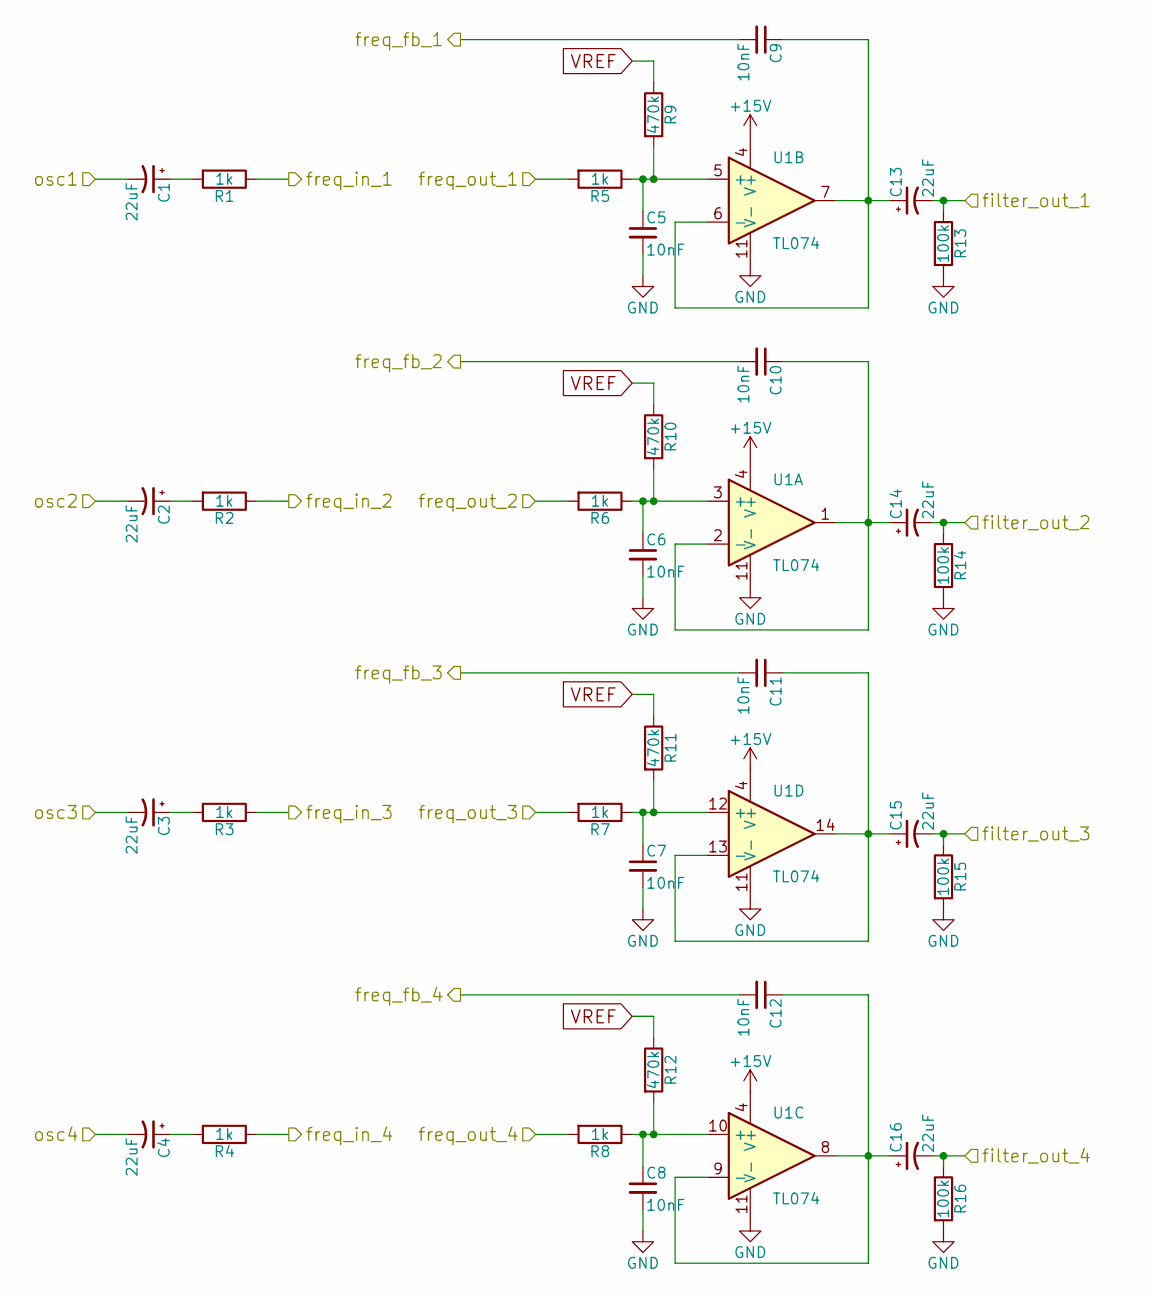
[picture p15: schematic vcf.sch]

Parts:
C1, C2, C3, C4, C13, C14, C15, C16: 22uF; CP_Elec_5x5.7
C5, C6, C7, C8, C9, C10, C11, C12: 10nF; 0805
R1, R2, R3, R4, R5, R6, R7, R8: 1k; 0805
R9, R10, R11, R12: 470k; 0805
R13, R14, R15, R16: 100k; 0805
U1: TL074; SOIC-14_W3.9mm

Connections:
+15V: U1.4 (V+); also elsewhere on the board
/Connectors/freq_fb_1: C9.2; also elsewhere on the board
/Connectors/freq_fb_2: C10.2; also elsewhere on the board
/Connectors/freq_fb_3: C11.2; also elsewhere on the board
/Connectors/freq_fb_4: C12.2; also elsewhere on the board
/Connectors/freq_in_1: R1.1; also elsewhere on the board
/Connectors/freq_in_2: R2.1; also elsewhere on the board
/Connectors/freq_in_3: R3.1; also elsewhere on the board
/Connectors/freq_in_4: R4.1; also elsewhere on the board
/Connectors/freq_out_1: R5.2; also elsewhere on the board
/Connectors/freq_out_2: R6.2; also elsewhere on the board
/Connectors/freq_out_3: R7.2; also elsewhere on the board
/Connectors/freq_out_4: R8.2; also elsewhere on the board
/Filters/filter_out_1: C13.2, R13.1; also elsewhere on the board
/Filters/filter_out_2: C14.2, R14.1; also elsewhere on the board
/Filters/filter_out_3: C15.2, R15.1; also elsewhere on the board
/Filters/filter_out_4: C16.2, R16.1; also elsewhere on the board
/Filters/osc1: C1.2; also elsewhere on the board
/Filters/osc2: C2.2; also elsewhere on the board
/Filters/osc3: C3.2; also elsewhere on the board
/Filters/osc4: C4.2; also elsewhere on the board
GND: C5.2, C6.2, C7.2, C8.2, R13.2, R14.2, R15.2, R16.2, U1.11 (V-); also elsewhere on the board
unnamed: C1.1, R1.2
unnamed: C2.1, R2.2
unnamed: C3.1, R3.2
unnamed: C4.1, R4.2
unnamed: C5.1, R5.1, R9.2, U1.5 (+)
unnamed: C6.1, R6.1, R10.2, U1.3 (+)
unnamed: C7.1, R7.1, R11.2, U1.12 (+)
unnamed: C8.1, R8.1, R12.2, U1.10 (+)
unnamed: C10.1, C14.1, U1.1, U1.2 (-)
unnamed: C11.1, C15.1, U1.13 (-), U1.14
unnamed: C12.1, C16.1, U1.8, U1.9 (-)
unnamed: C9.1, C13.1, U1.6 (-), U1.7
VREF: R9.1, R10.1, R11.1, R12.1; also elsewhere on the board

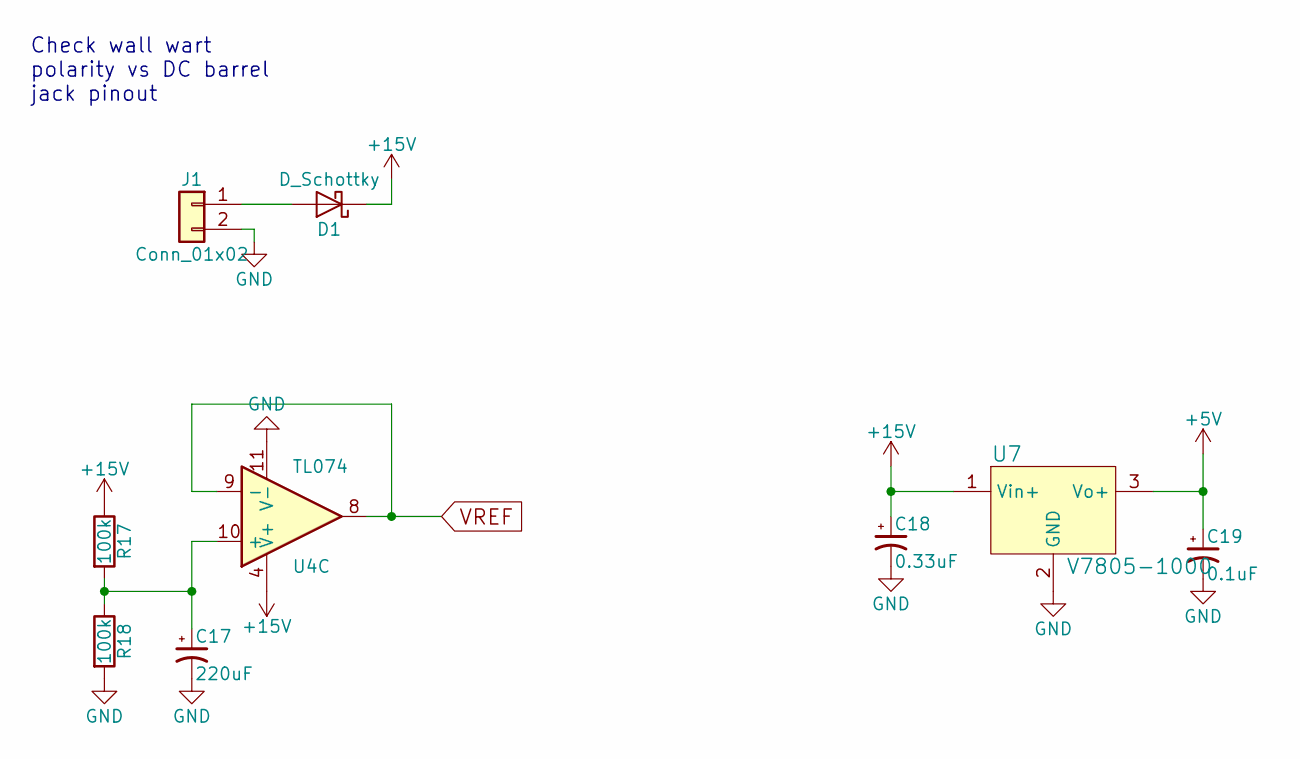
[picture p16: schematic power.sch]

Parts:
C17: 220uF; CP_Elec_8x10
C18: 0.33uF; 0805
C19: 0.1uF; 0805
D1: D_Schottky; D_SMB
J1: Conn_01x02; Pin_Header_Straight_1x02_Pitch2.00mm
R17, R18: 100k; 0805
U4: TL074; SOIC-14_W3.9mm
U7: V7805-1000; 3-SIP_Module_V7805-1000; MPN V7805-1000; Digi-Key_PN 102-1715-ND

Connections:
+5V: C19.1, U7.3 (Vo+); also elsewhere on the board
+15V: C18.1, D1.1 (K), R17.1, U4.4 (V+), U7.1 (Vin+); also elsewhere on the board
GND: C17.2, C18.2, C19.2, J1.2, R18.2, U4.11 (V-), U7.2 (GND); also elsewhere on the board
unnamed: C17.1, R17.2, R18.1, U4.10 (+)
unnamed: D1.2 (A), J1.1
VREF: U4.8, U4.9 (-); also elsewhere on the board

Notes on the sheet:
Check wall wart polarity vs DC barrel jack pinout

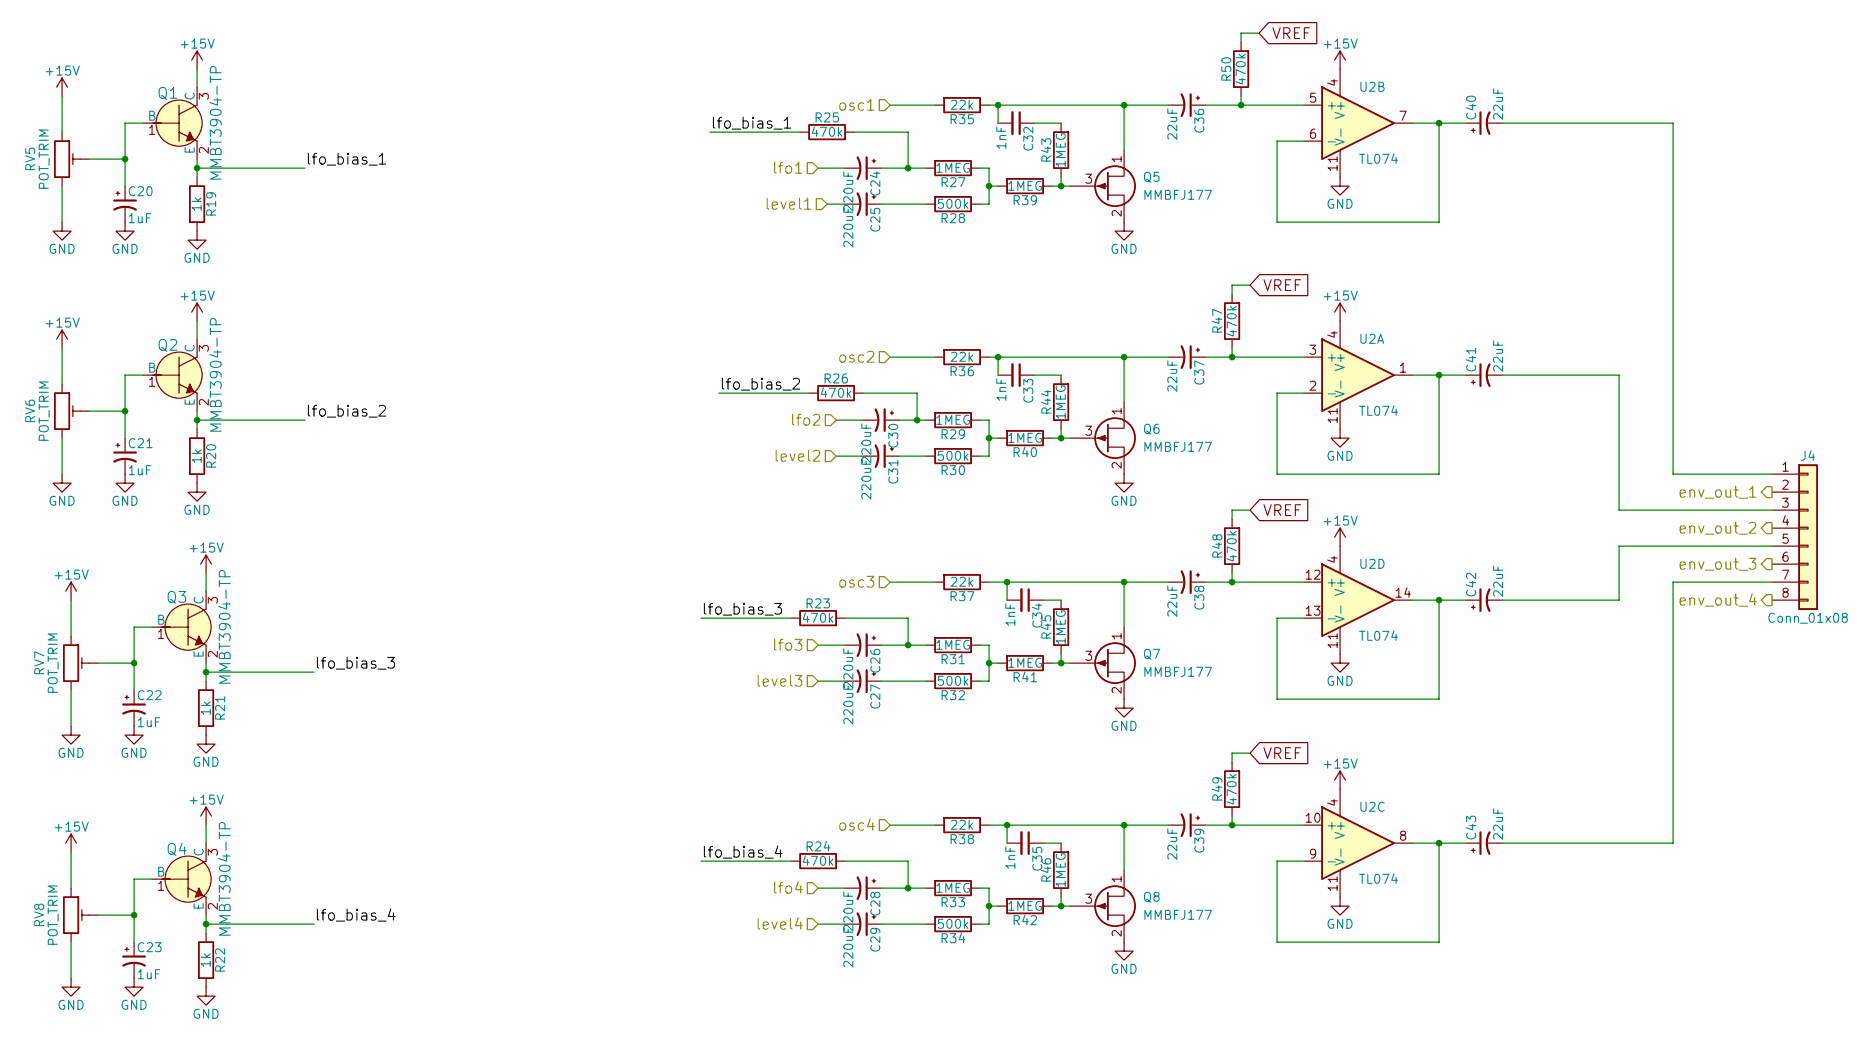
[picture p17: schematic vca.sch]

Parts:
C20, C21, C22, C23: 1uF; CP_Elec_4x4.5
C24, C25, C26, C27, C28, C29, C30, C31: 220uF; CP_Elec_8x10
C32, C33, C34, C35: 1nF; 0805
C36, C37, C38, C39, C40, C41, C42, C43: 22uF; CP_Elec_5x5.7
J4: Conn_01x08; Pin_Header_Straight_1x08_Pitch2.54mm
Q1, Q2, Q3, Q4: MMBT3904-TP; SOT-23-3; MPN MMBT3904-TP; Digi-Key_PN MMBT3904TPMSCT-ND
Q5, Q6, Q7, Q8: MMBFJ177; SOT-23-3
R19, R20, R21, R22: 1k; 0805
R23, R24, R25, R26, R47, R48, R49, R50: 470k; 0805
R27, R29, R31, R33, R39, R40, R41, R42, R43, R44, R45, R46: 1MEG; 0805
R28, R30, R32, R34: 500k; 0805
R35, R36, R37, R38: 22k; 0805
RV5, RV6, RV7, RV8: POT_TRIM; Potentiometer_Trimmer-EVM3E
U2: TL074; SOIC-14_W3.9mm

Connections:
+15V: Q1.3 (C), Q2.3 (C), Q3.3 (C), Q4.3 (C), RV5.1, RV6.1, RV7.1, RV8.1, U2.4 (V+); also elsewhere on the board
/Envelope/env_out_1: J4.2; also elsewhere on the board
/Envelope/env_out_2: J4.4; also elsewhere on the board
/Envelope/env_out_3: J4.6; also elsewhere on the board
/Envelope/env_out_4: J4.8; also elsewhere on the board
/Envelope/lfo_bias_1: Q1.2 (E), R19.1, R25.1
/Envelope/lfo_bias_2: Q2.2 (E), R20.1, R26.1
/Envelope/lfo_bias_3: Q3.2 (E), R21.1, R23.1
/Envelope/lfo_bias_4: Q4.2 (E), R22.1, R24.1
/Filters/filter_out_1: R35.2; also elsewhere on the board
/Filters/filter_out_2: R36.2; also elsewhere on the board
/Filters/filter_out_3: R37.2; also elsewhere on the board
/Filters/filter_out_4: R38.2; also elsewhere on the board
/Microcontroller/envelope_pwm_1: C25.2; also elsewhere on the board
/Microcontroller/envelope_pwm_2: C31.2; also elsewhere on the board
/Microcontroller/envelope_pwm_3: C27.2; also elsewhere on the board
/Microcontroller/envelope_pwm_4: C29.2; also elsewhere on the board
/lfo_out_1: C24.2; also elsewhere on the board
/lfo_out_2: C30.2; also elsewhere on the board
/lfo_out_3: C26.2; also elsewhere on the board
/lfo_out_4: C28.2; also elsewhere on the board
GND: C20.2, C21.2, C22.2, C23.2, Q5.2 (S), Q6.2 (S), Q7.2 (S), Q8.2 (S), R19.2, R20.2, R21.2, R22.2, RV5.3, RV6.3, RV7.3, RV8.3, U2.11 (V-); also elsewhere on the board
unnamed: C20.1, Q1.1 (B), RV5.2
unnamed: C21.1, Q2.1 (B), RV6.2
unnamed: C22.1, Q3.1 (B), RV7.2
unnamed: C23.1, Q4.1 (B), RV8.2
unnamed: C24.1, R25.2, R27.2
unnamed: C25.1, R28.2
unnamed: C26.1, R23.2, R31.2
unnamed: C27.1, R32.2
unnamed: C28.1, R24.2, R33.2
unnamed: C29.1, R34.2
unnamed: C30.1, R26.2, R29.2
unnamed: C31.1, R30.2
unnamed: C32.1, R43.2
unnamed: C32.2, C36.2, Q5.1 (D), R35.1
unnamed: C33.1, R44.2
unnamed: C33.2, C37.2, Q6.1 (D), R36.1
unnamed: C34.1, R45.2
unnamed: C34.2, C38.2, Q7.1 (D), R37.1
unnamed: C35.1, R46.2
unnamed: C35.2, C39.2, Q8.1 (D), R38.1
unnamed: C36.1, R50.1, U2.5 (+)
unnamed: C37.1, R47.1, U2.3 (+)
unnamed: C38.1, R48.1, U2.12 (+)
unnamed: C39.1, R49.1, U2.10 (+)
unnamed: C40.1, U2.6 (-), U2.7
unnamed: C40.2, J4.1
unnamed: C41.1, U2.1, U2.2 (-)
unnamed: C41.2, J4.3
unnamed: C42.1, U2.13 (-), U2.14
unnamed: C42.2, J4.5
unnamed: C43.1, U2.8, U2.9 (-)
unnamed: C43.2, J4.7
unnamed: Q5.3 (G), R39.1, R43.1
unnamed: Q6.3 (G), R40.1, R44.1
unnamed: Q7.3 (G), R41.1, R45.1
unnamed: Q8.3 (G), R42.1, R46.1
unnamed: R27.1, R28.1, R39.2
unnamed: R29.1, R30.1, R40.2
unnamed: R31.1, R32.1, R41.2
unnamed: R33.1, R34.1, R42.2
VREF: R47.2, R48.2, R49.2, R50.2; also elsewhere on the board

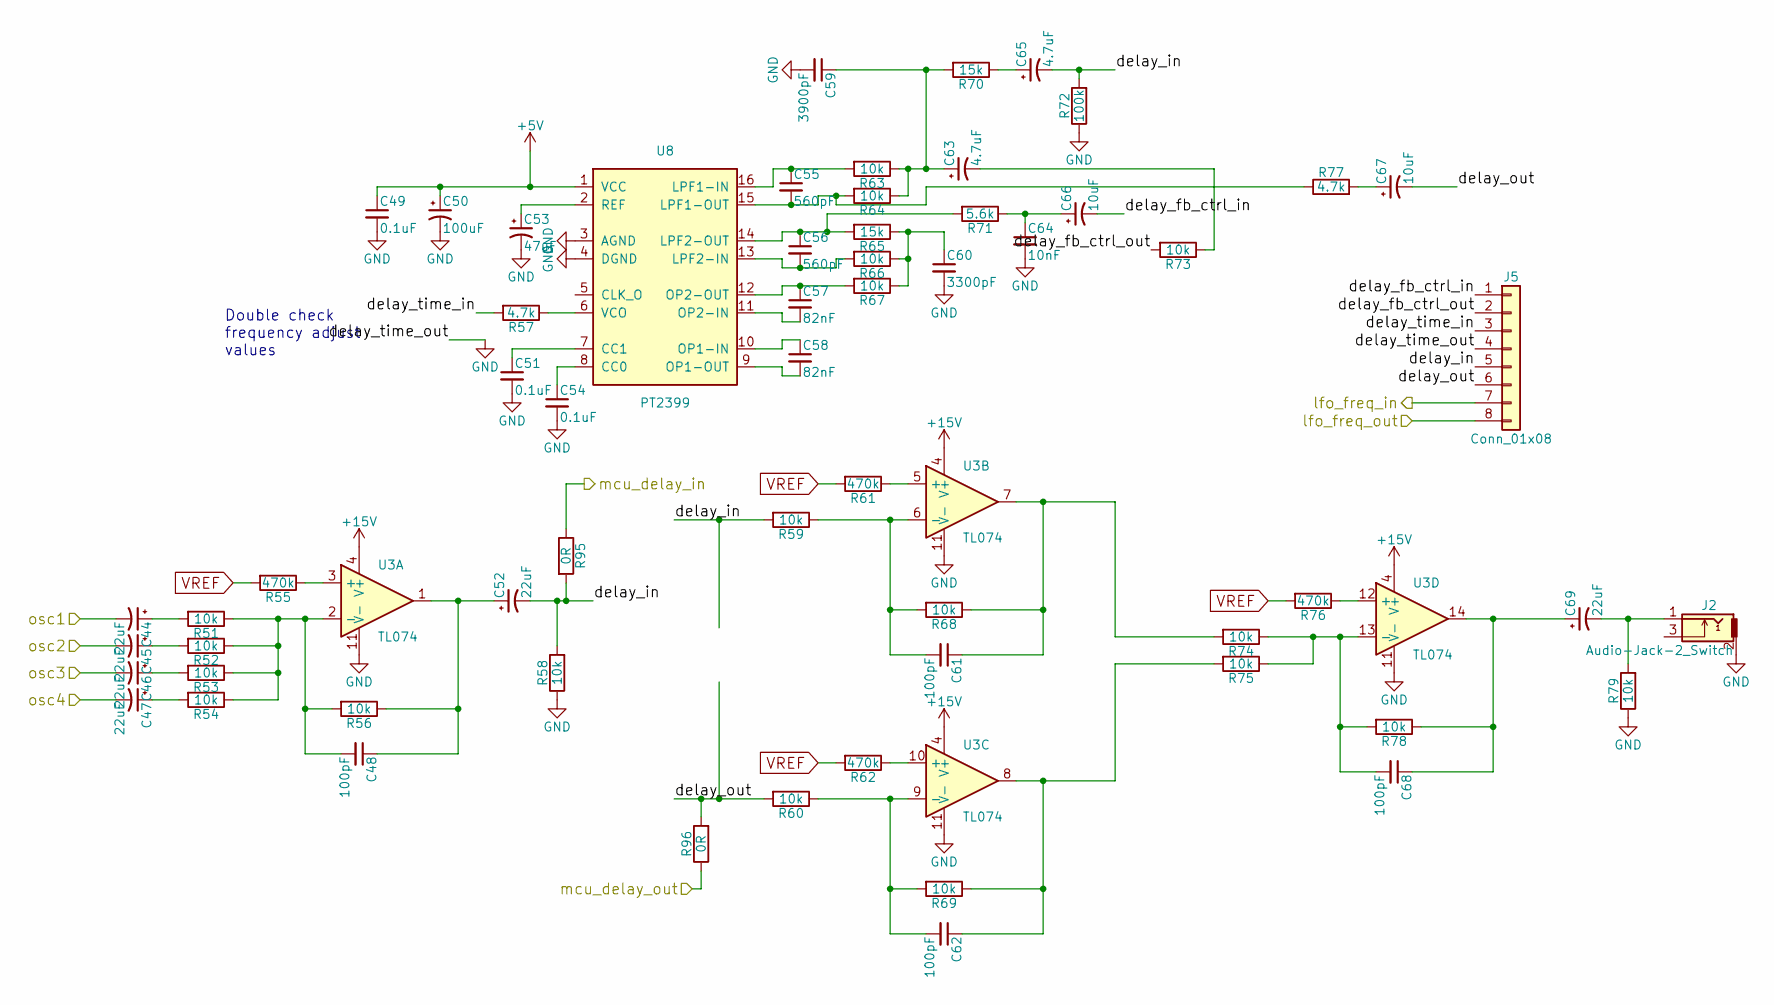
[picture p18: schematic mixer.sch]

Parts:
C44, C45, C46, C47, C52, C69: 22uF; CP_Elec_5x5.7
C48, C61, C62, C68: 100pF; 0805
C49, C51, C54: 0.1uF; 0805
C50: 100uF; CP_Elec_5x5.7
C53: 47uF; CP_Elec_4x5.7
C55, C56: 560pF; 0805
C57, C58: 82nF; 0805
C59: 3900pF; 0805
C60: 3300pF; 0805
C63, C65: 4.7uF; CP_Elec_4x5.7
C64: 10nF; 0805
C66, C67: 10uF; CP_Elec_4x5.7
J2: Audio-Jack-2_Switch; Pin_Header_Straight_1x03_Pitch2.00mm
J5: Conn_01x08; Pin_Header_Straight_1x08_Pitch2.54mm
R51, R52, R53, R54, R56, R58, R59, R60, R63, R64, R66, R67, R68, R69, R73, R74, R75, R78, R79: 10k; 0805
R55, R61, R62, R76: 470k; 0805
R57, R77: 4.7k; 0805
R65, R70: 15k; 0805
R71: 5.6k; 0805
R72: 100k; 0805
R95, R96: 0R; 0805
U3: TL074; SOIC-14_W3.9mm
U8: PT2399; DIP-16_W7.62mm

Connections:
+5V: C49.1, C50.1, U8.1 (VCC); also elsewhere on the board
+15V: U3.4 (V+); also elsewhere on the board
/Envelope/env_out_1: C44.2; also elsewhere on the board
/Envelope/env_out_2: C45.2; also elsewhere on the board
/Envelope/env_out_3: C46.2; also elsewhere on the board
/Envelope/env_out_4: C47.2; also elsewhere on the board
/Mixer and Effects/delay_fb_ctrl_in: C66.2, J5.1
/Mixer and Effects/delay_fb_ctrl_out: J5.2, R73.2
/Mixer and Effects/delay_in: C52.2, C65.2, J5.5, R58.2, R59.2, R72.2, R95.2
/Mixer and Effects/delay_out: C67.2, J5.6, R60.2, R96.2
/Mixer and Effects/delay_time_in: J5.3, R57.2
/lfo_freq_in: J5.7; also elsewhere on the board
/lfo_freq_out: J5.8; also elsewhere on the board
/mcu_delay_in: R95.1; also elsewhere on the board
/mcu_delay_out: R96.1; also elsewhere on the board
GND: C49.2, C50.2, C51.2, C53.2, C54.2, C59.2, C60.2, C64.2, J2.2, J5.4, R58.1, R72.1, R79.1, U3.11 (V-), U8.3 (AGND), U8.4 (DGND); also elsewhere on the board
unnamed: C44.1, R51.2
unnamed: C45.1, R52.2
unnamed: C46.1, R53.2
unnamed: C47.1, R54.2
unnamed: C48.1, C52.1, R56.1, U3.1
unnamed: C48.2, R51.1, R52.1, R53.1, R54.1, R56.2, U3.2 (-)
unnamed: C51.1, U8.7 (CC1)
unnamed: C53.1, U8.2 (REF)
unnamed: C54.1, U8.8 (CC0)
unnamed: C55.1, R63.2, U8.16 (LPF1-IN)
unnamed: C55.2, R64.2, R77.1, U8.15 (LPF1-OUT)
unnamed: C56.1, R65.2, R71.2, U8.14 (LPF2-OUT)
unnamed: C56.2, R66.2, U8.13 (LPF2-IN)
unnamed: C57.1, R67.2, U8.12 (OP2-OUT)
unnamed: C57.2, U8.11 (OP2-IN)
unnamed: C58.1, U8.10 (OP1-IN)
unnamed: C58.2, U8.9 (OP1-OUT)
unnamed: C59.1, C63.1, R63.1, R64.1, R70.2
unnamed: C60.1, R65.1, R66.1, R67.1
unnamed: C61.1, R68.1, R74.2, U3.7
unnamed: C61.2, R59.1, R68.2, U3.6 (-)
unnamed: C62.1, R69.1, R75.2, U3.8
unnamed: C62.2, R60.1, R69.2, U3.9 (-)
unnamed: C63.2, R73.1
unnamed: C64.1, C66.1, R71.1
unnamed: C65.1, R70.1
unnamed: C67.1, R77.2
unnamed: C68.1, C69.1, R78.1, U3.14
unnamed: C68.2, R74.1, R75.1, R78.2, U3.13 (-)
unnamed: C69.2, J2.1, R79.2
unnamed: R55.1, U3.3 (+)
unnamed: R57.1, U8.6 (VCO)
unnamed: R61.1, U3.5 (+)
unnamed: R62.1, U3.10 (+)
unnamed: R76.1, U3.12 (+)
VREF: R55.2, R61.2, R62.2, R76.2; also elsewhere on the board

Notes on the sheet:
Double check frequency adjust values
