pmusgrave/synth_psoc/Hardware/Synth_Engine/synth_psoc.kicad_pcb

## KiCad design Hardware/Synth_Engine/synth_psoc.kicad_pcb (continued)

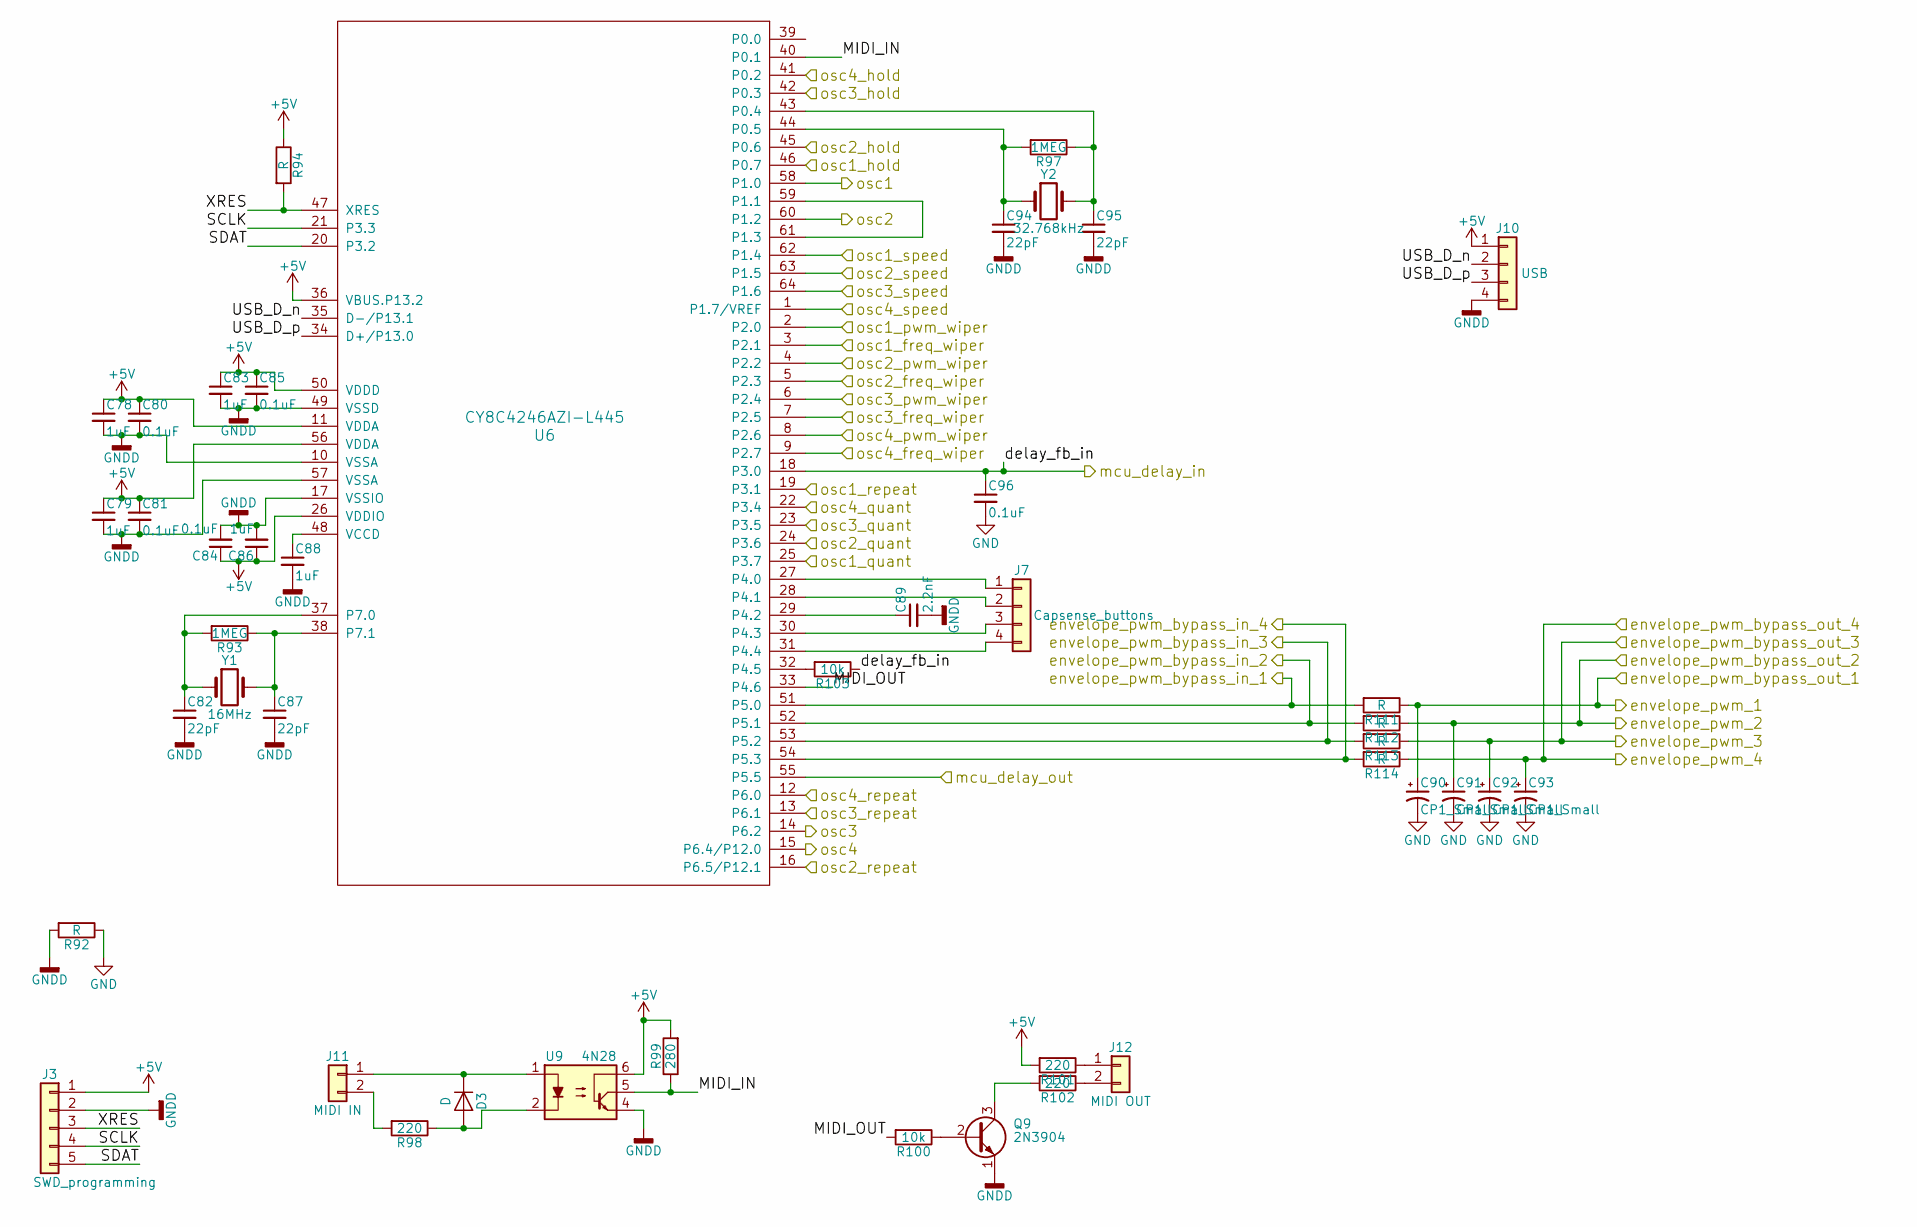
[picture p19: schematic mcu.sch]

Parts:
C78, C79, C83, C86, C88: 1uF; 0805
C80, C81, C84, C85, C96: 0.1uF; 0805
C82, C87, C94, C95: 22pF; 0805
C89: 2.2nF; 0805
C90, C91, C92, C93: CP1_Small; CP_Elec_5x5.7
D3: D; SOT-23-3
J3: SWD_programming; Pin_Header_Straight_1x05_Pitch2.54mm
J7: Capsense_buttons; Pin_Header_Straight_1x04_Pitch2.00mm
J10: USB; Pin_Header_Straight_1x04_Pitch2.00mm
J11: MIDI IN; Pin_Header_Straight_1x02_Pitch2.00mm
J12: MIDI OUT; Pin_Header_Straight_1x02_Pitch2.00mm
Q9: 2N3904; SOT-23-3
R92, R94, R111, R112, R113, R114: R; 0805
R93, R97: 1MEG; 0805
R98, R101, R102: 220; 0805
R99: 280; 0805
R100, R103: 10k; 0805
U6: CY8C4246AZI-L445; LQFP-64_10x10mm
U9: 4N28; DIP-8_W7.62mm
Y1: 16MHz; Crystal_SMD_HC49-SD_HandSoldering
Y2: 32.768kHz; 1206

Connections:
+5V: C78.1, C79.1, C80.1, C81.1, C83.1, C84.1, C85.1, C86.1, J3.1, J10.1, R94.1, R99.2, R101.2, U6.11 (VDDA), U6.26 (VDDIO), U6.36 (VBUS.P13.2), U6.50 (VDDD), U6.56 (VDDA), U9.6; also elsewhere on the board
/Connectors/envelope_pwm_bypass_in_1: R111.2, U6.51 (P5.0); also elsewhere on the board
/Connectors/envelope_pwm_bypass_in_2: R112.2, U6.52 (P5.1); also elsewhere on the board
/Connectors/envelope_pwm_bypass_in_3: R113.2, U6.53 (P5.2); also elsewhere on the board
/Connectors/envelope_pwm_bypass_in_4: R114.2, U6.54 (P5.3); also elsewhere on the board
/Connectors/osc1_freq_wiper: U6.3 (P2.1); also elsewhere on the board
/Connectors/osc1_hold: U6.46 (P0.7); also elsewhere on the board
/Connectors/osc1_pwm_wiper: U6.2 (P2.0); also elsewhere on the board
/Connectors/osc1_quant: U6.25 (P3.7); also elsewhere on the board
/Connectors/osc1_repeat: U6.19 (P3.1); also elsewhere on the board
/Connectors/osc1_speed: U6.62 (P1.4); also elsewhere on the board
/Connectors/osc2_freq_wiper: U6.5 (P2.3); also elsewhere on the board
/Connectors/osc2_hold: U6.45 (P0.6); also elsewhere on the board
/Connectors/osc2_pwm_wiper: U6.4 (P2.2); also elsewhere on the board
/Connectors/osc2_quant: U6.24 (P3.6); also elsewhere on the board
/Connectors/osc2_repeat: U6.16 (P6.5/P12.1); also elsewhere on the board
/Connectors/osc2_speed: U6.63 (P1.5); also elsewhere on the board
/Connectors/osc3_freq_wiper: U6.7 (P2.5); also elsewhere on the board
/Connectors/osc3_hold: U6.42 (P0.3); also elsewhere on the board
/Connectors/osc3_pwm_wiper: U6.6 (P2.4); also elsewhere on the board
/Connectors/osc3_quant: U6.23 (P3.5); also elsewhere on the board
/Connectors/osc3_repeat: U6.13 (P6.1); also elsewhere on the board
/Connectors/osc3_speed: U6.64 (P1.6); also elsewhere on the board
/Connectors/osc4_freq_wiper: U6.9 (P2.7); also elsewhere on the board
/Connectors/osc4_hold: U6.41 (P0.2); also elsewhere on the board
/Connectors/osc4_pwm_wiper: U6.8 (P2.6); also elsewhere on the board
/Connectors/osc4_quant: U6.22 (P3.4); also elsewhere on the board
/Connectors/osc4_repeat: U6.12 (P6.0); also elsewhere on the board
/Connectors/osc4_speed: U6.1 (P1.7/VREF); also elsewhere on the board
/Filters/osc1: U6.58 (P1.0); also elsewhere on the board
/Filters/osc2: U6.60 (P1.2); also elsewhere on the board
/Filters/osc3: U6.14 (P6.2); also elsewhere on the board
/Filters/osc4: U6.15 (P6.4/P12.0); also elsewhere on the board
/Microcontroller/MIDI_IN: R99.1, U6.40 (P0.1), U9.5
/Microcontroller/MIDI_OUT: R100.2, U6.33 (P4.6)
/Microcontroller/SCLK: J3.4, U6.21 (P3.3)
/Microcontroller/SDAT: J3.5, U6.20 (P3.2)
/Microcontroller/USB_D_n: J10.2, U6.35 (D-/P13.1)
/Microcontroller/USB_D_p: J10.3, U6.34 (D+/P13.0)
/Microcontroller/XRES: J3.3, R94.2, U6.47 (XRES)
/Microcontroller/envelope_pwm_1: C90.1, R111.1; also elsewhere on the board
/Microcontroller/envelope_pwm_2: C91.1, R112.1; also elsewhere on the board
/Microcontroller/envelope_pwm_3: C92.1, R113.1; also elsewhere on the board
/Microcontroller/envelope_pwm_4: C93.1, R114.1; also elsewhere on the board
/mcu_delay_in: C96.1, R103.1, U6.18 (P3.0); also elsewhere on the board
/mcu_delay_out: U6.55 (P5.5); also elsewhere on the board
GND: C90.2, C91.2, C92.2, C93.2, C96.2, R92.1; also elsewhere on the board
GNDD: C78.2, C79.2, C80.2, C81.2, C82.2, C83.2, C84.2, C85.2, C86.2, C87.2, C88.2, C89.2, C94.2, C95.2, J3.2, J10.4, Q9.1 (E), R92.2, U6.10 (VSSA), U6.17 (VSSIO), U6.49 (VSSD), U6.57 (VSSA), U9.4
unnamed: C82.1, R93.2, U6.37 (P7.0), Y1.1
unnamed: C87.1, R93.1, U6.38 (P7.1), Y1.2
unnamed: C88.1, U6.48 (VCCD)
unnamed: C89.1, U6.29 (P4.2)
unnamed: C94.1, R97.2, U6.44 (P0.5), Y2.1
unnamed: C95.1, R97.1, U6.43 (P0.4), Y2.2
unnamed: D3.1 (K), J11.1, U9.1
unnamed: D3.2 (A), R98.1, U9.2
unnamed: J7.1, U6.27 (P4.0)
unnamed: J7.2, U6.28 (P4.1)
unnamed: J7.3, U6.30 (P4.3)
unnamed: J7.4, U6.31 (P4.4)
unnamed: J11.2, R98.2
unnamed: J12.1, R101.1
unnamed: J12.2, R102.1
unnamed: Q9.2 (B), R100.1
unnamed: Q9.3 (C), R102.2
unnamed: R103.2, U6.32 (P4.5)
unnamed: U6.59 (P1.1), U6.61 (P1.3)

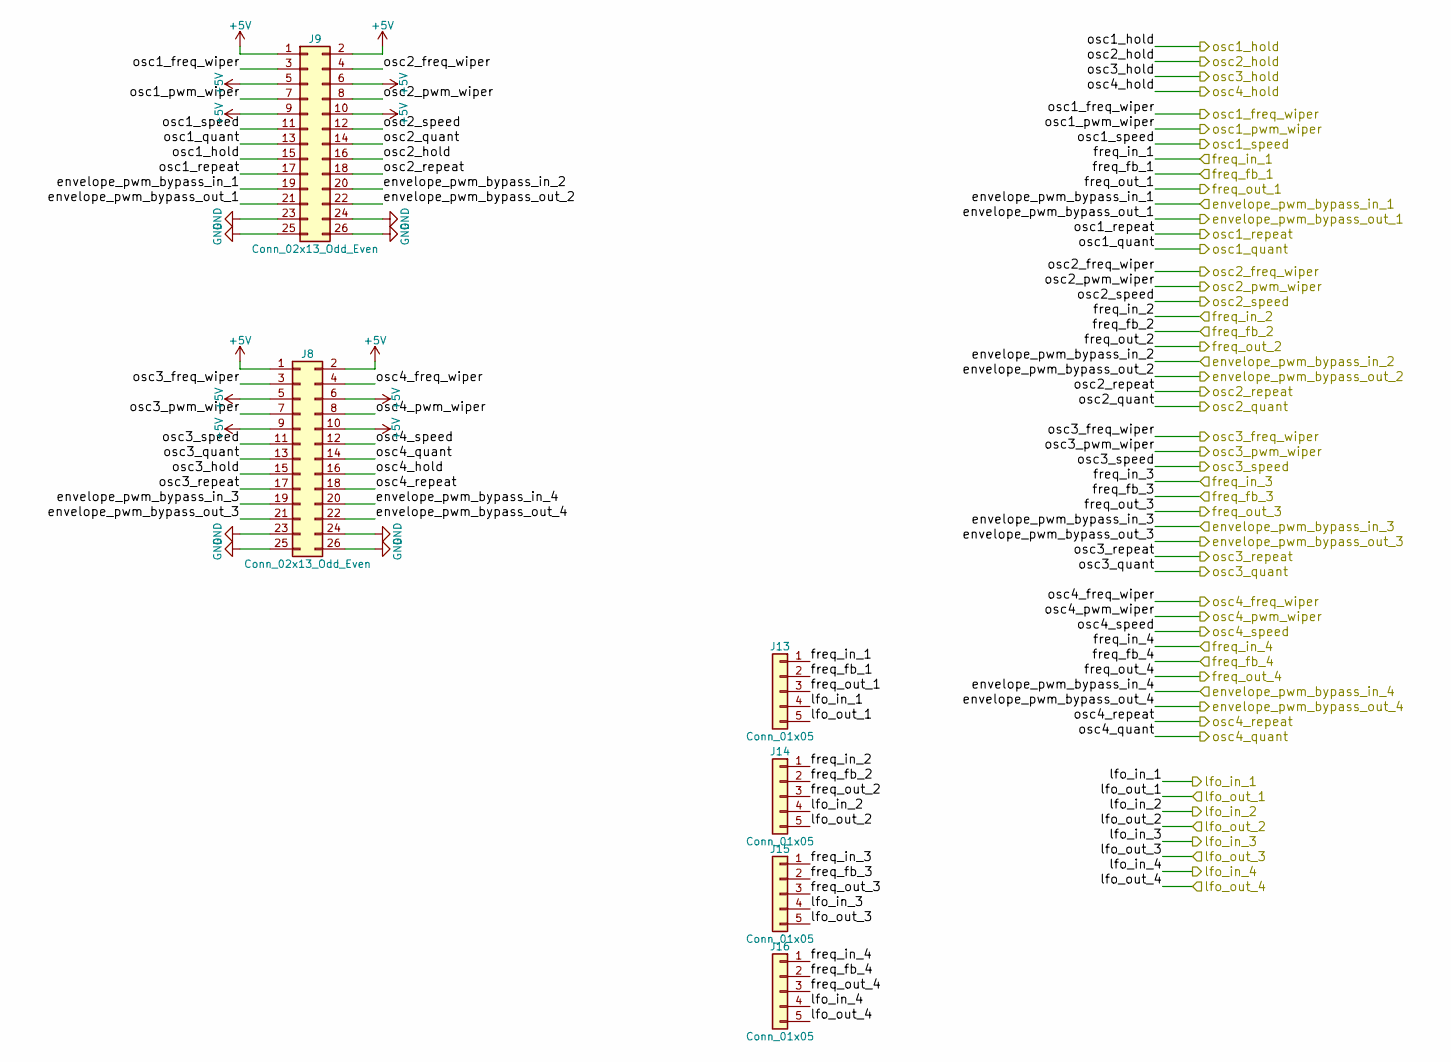
[picture p20: schematic connectors.sch]

Parts:
J8, J9: Conn_02x13_Odd_Even; Pin_Header_Straight_2x13_Pitch2.54mm
J13, J14, J15, J16: Conn_01x05; Pin_Header_Straight_1x05_Pitch2.54mm

Connections:
+5V: J8.1, J8.2, J8.5, J8.6, J8.9, J8.10, J9.1, J9.2, J9.5, J9.6, J9.9, J9.10; also elsewhere on the board
/Connectors/envelope_pwm_bypass_in_1: J9.19; also elsewhere on the board
/Connectors/envelope_pwm_bypass_in_2: J9.20; also elsewhere on the board
/Connectors/envelope_pwm_bypass_in_3: J8.19; also elsewhere on the board
/Connectors/envelope_pwm_bypass_in_4: J8.20; also elsewhere on the board
/Connectors/freq_fb_1: J13.2; also elsewhere on the board
/Connectors/freq_fb_2: J14.2; also elsewhere on the board
/Connectors/freq_fb_3: J15.2; also elsewhere on the board
/Connectors/freq_fb_4: J16.2; also elsewhere on the board
/Connectors/freq_in_1: J13.1; also elsewhere on the board
/Connectors/freq_in_2: J14.1; also elsewhere on the board
/Connectors/freq_in_3: J15.1; also elsewhere on the board
/Connectors/freq_in_4: J16.1; also elsewhere on the board
/Connectors/freq_out_1: J13.3; also elsewhere on the board
/Connectors/freq_out_2: J14.3; also elsewhere on the board
/Connectors/freq_out_3: J15.3; also elsewhere on the board
/Connectors/freq_out_4: J16.3; also elsewhere on the board
/Connectors/osc1_freq_wiper: J9.3; also elsewhere on the board
/Connectors/osc1_hold: J9.15; also elsewhere on the board
/Connectors/osc1_pwm_wiper: J9.7; also elsewhere on the board
/Connectors/osc1_quant: J9.13; also elsewhere on the board
/Connectors/osc1_repeat: J9.17; also elsewhere on the board
/Connectors/osc1_speed: J9.11; also elsewhere on the board
/Connectors/osc2_freq_wiper: J9.4; also elsewhere on the board
/Connectors/osc2_hold: J9.16; also elsewhere on the board
/Connectors/osc2_pwm_wiper: J9.8; also elsewhere on the board
/Connectors/osc2_quant: J9.14; also elsewhere on the board
/Connectors/osc2_repeat: J9.18; also elsewhere on the board
/Connectors/osc2_speed: J9.12; also elsewhere on the board
/Connectors/osc3_freq_wiper: J8.3; also elsewhere on the board
/Connectors/osc3_hold: J8.15; also elsewhere on the board
/Connectors/osc3_pwm_wiper: J8.7; also elsewhere on the board
/Connectors/osc3_quant: J8.13; also elsewhere on the board
/Connectors/osc3_repeat: J8.17; also elsewhere on the board
/Connectors/osc3_speed: J8.11; also elsewhere on the board
/Connectors/osc4_freq_wiper: J8.4; also elsewhere on the board
/Connectors/osc4_hold: J8.16; also elsewhere on the board
/Connectors/osc4_pwm_wiper: J8.8; also elsewhere on the board
/Connectors/osc4_quant: J8.14; also elsewhere on the board
/Connectors/osc4_repeat: J8.18; also elsewhere on the board
/Connectors/osc4_speed: J8.12; also elsewhere on the board
/Microcontroller/envelope_pwm_1: J9.21; also elsewhere on the board
/Microcontroller/envelope_pwm_2: J9.22; also elsewhere on the board
/Microcontroller/envelope_pwm_3: J8.21; also elsewhere on the board
/Microcontroller/envelope_pwm_4: J8.22; also elsewhere on the board
/lfo_in_1: J13.4; also elsewhere on the board
/lfo_in_2: J14.4; also elsewhere on the board
/lfo_in_3: J15.4; also elsewhere on the board
/lfo_in_4: J16.4; also elsewhere on the board
/lfo_out_1: J13.5; also elsewhere on the board
/lfo_out_2: J14.5; also elsewhere on the board
/lfo_out_3: J15.5; also elsewhere on the board
/lfo_out_4: J16.5; also elsewhere on the board
GND: J8.23, J8.24, J8.25, J8.26, J9.23, J9.24, J9.25, J9.26; also elsewhere on the board

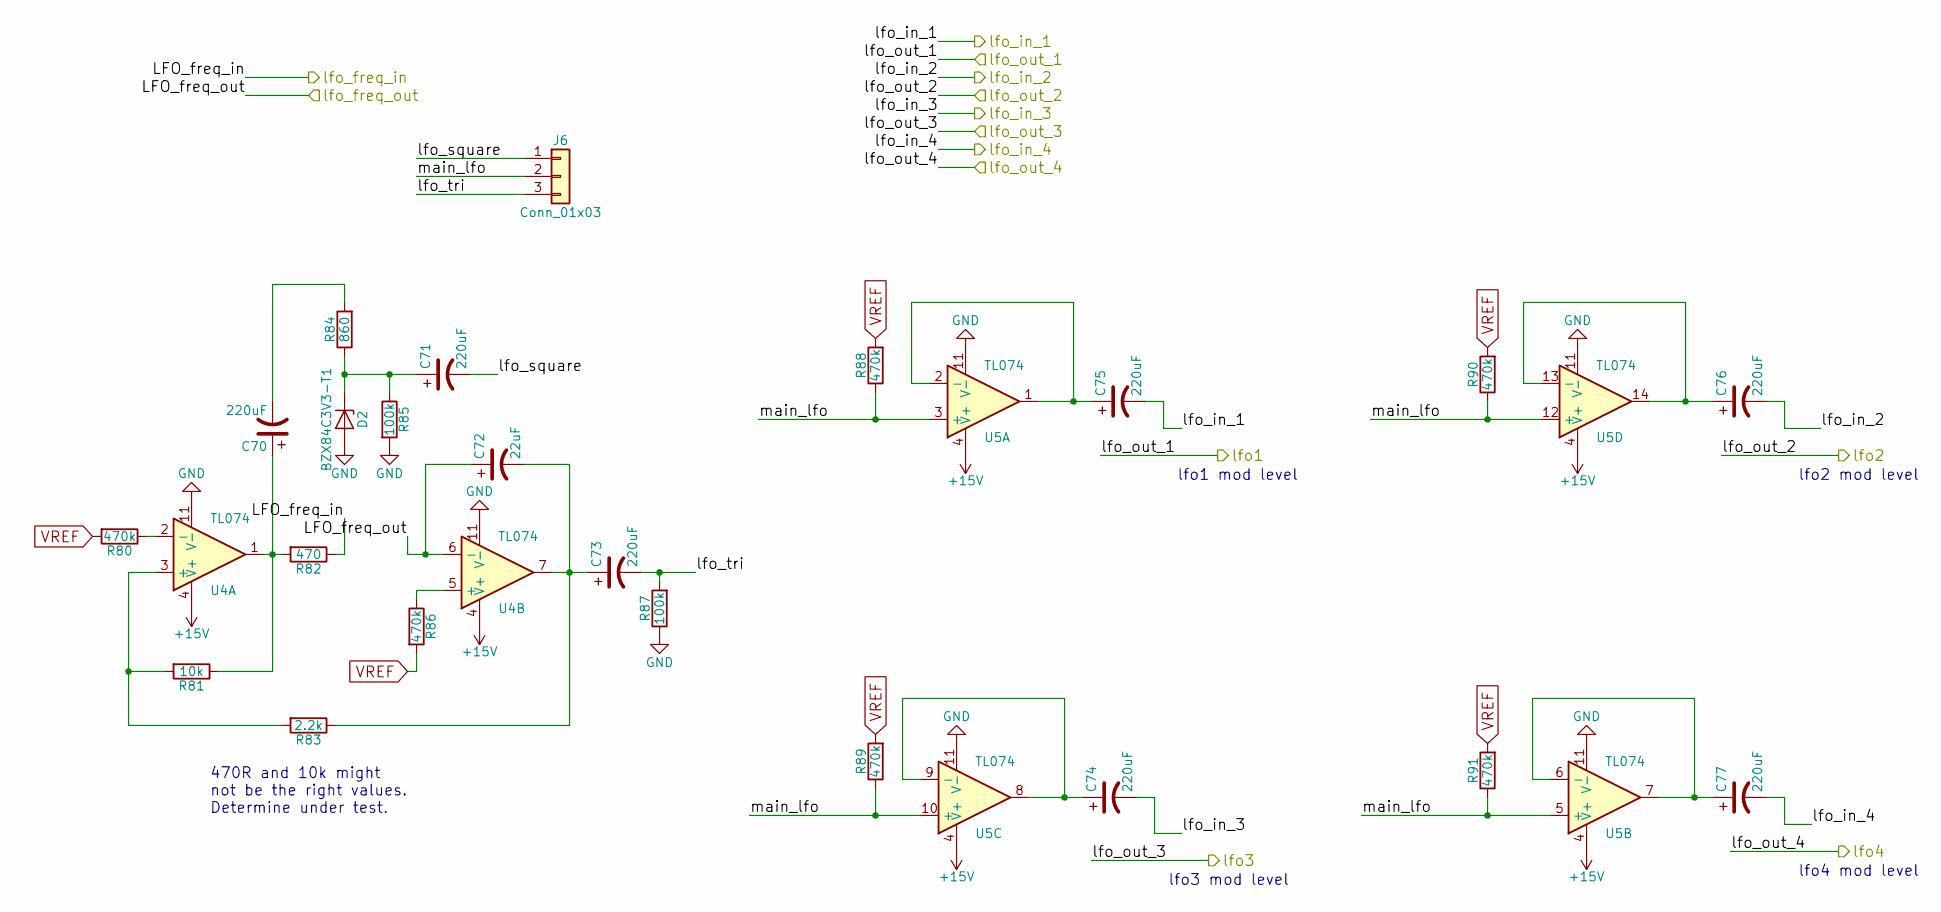
[picture p21: schematic lfo.sch]

Parts:
C70, C71, C73, C74, C75, C76, C77: 220uF; CP_Elec_8x10
C72: 22uF; CP_Elec_5x5.7
D2: BZX84C3V3-T1; SOT-23-3
J6: Conn_01x03; Pin_Header_Straight_1x03_Pitch2.54mm
R80, R86, R88, R89, R90, R91: 470k; 0805
R81: 10k; 0805
R82: 470; 0805
R83: 2.2k; 0805
R84: 860; 0805
R85, R87: 100k; 0805
U4, U5: TL074; SOIC-14_W3.9mm

Connections:
+15V: U4.4 (V+), U5.4 (V+); also elsewhere on the board
/LFO Modulation and Routing/lfo_square: C71.2, J6.1
/LFO Modulation and Routing/lfo_tri: C73.2, J6.3, R87.2
/LFO Modulation and Routing/main_lfo: J6.2, R88.1, R89.1, R90.1, R91.1, U5.3 (+), U5.5 (+), U5.10 (+), U5.12 (+)
/lfo_freq_in: R82.1; also elsewhere on the board
/lfo_freq_out: C72.1, U4.6 (-); also elsewhere on the board
/lfo_in_1: C75.2; also elsewhere on the board
/lfo_in_2: C76.2; also elsewhere on the board
/lfo_in_3: C74.2; also elsewhere on the board
/lfo_in_4: C77.2; also elsewhere on the board
GND: D2.2 (A), R85.2, R87.1, U4.11 (V-), U5.11 (V-); also elsewhere on the board
unnamed: C70.1, R81.1, R82.2, U4.1
unnamed: C70.2, R84.2
unnamed: C71.1, D2.1 (K), R84.1, R85.1
unnamed: C72.2, C73.1, R83.1, U4.7
unnamed: C74.1, U5.8, U5.9 (-)
unnamed: C75.1, U5.1, U5.2 (-)
unnamed: C76.1, U5.13 (-), U5.14
unnamed: C77.1, U5.6 (-), U5.7
unnamed: R80.1, U4.2 (-)
unnamed: R81.2, R83.2, U4.3 (+)
unnamed: R86.1, U4.5 (+)
VREF: R80.2, R86.2, R88.2, R89.2, R90.2, R91.2; also elsewhere on the board

Notes on the sheet:
470R and 10k might not be the right values. Determine under test.
lfo4 mod level
lfo2 mod level
lfo3 mod level
lfo1 mod level

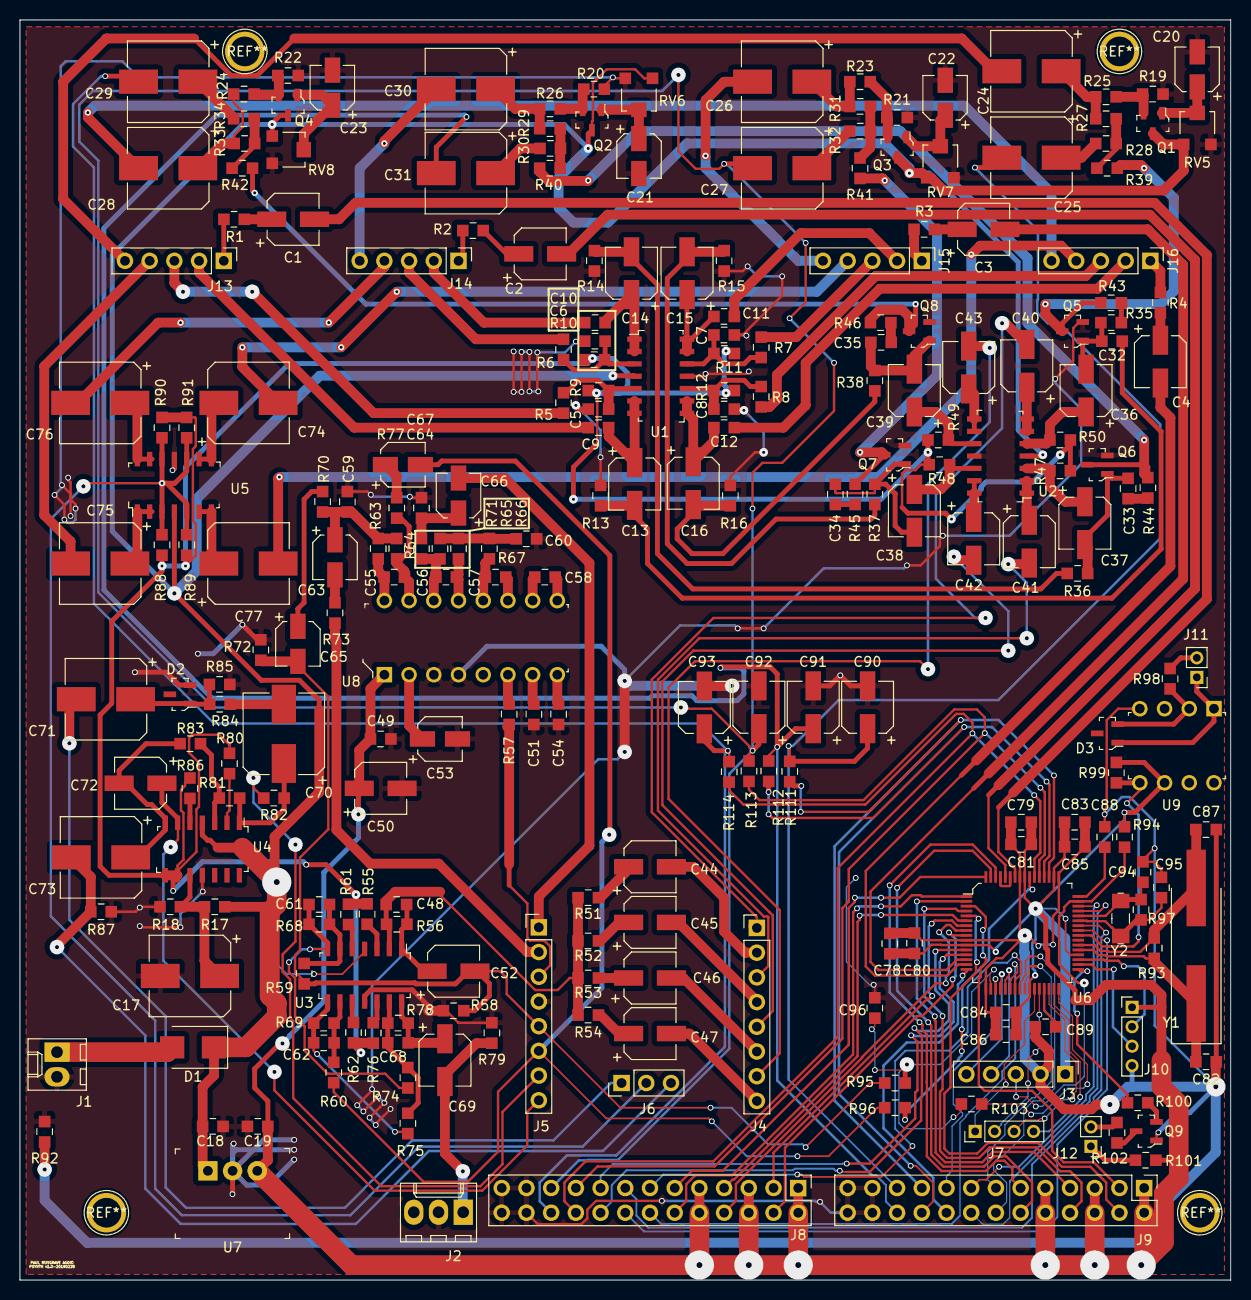
[picture p22: board synth_psoc.kicad_pcb from above]

Board: 2 copper layers, 124.5 x 129.5 mm, 246 parts (0 on the bottom side), 211 nets.
