pmusgrave/synth_psoc/Hardware/Synth_Engine/synth_psoc_v1.kicad_pcb

## KiCad design Hardware/Synth_Engine/synth_psoc_v1.kicad_pcb (2019-01-17, an earlier design)

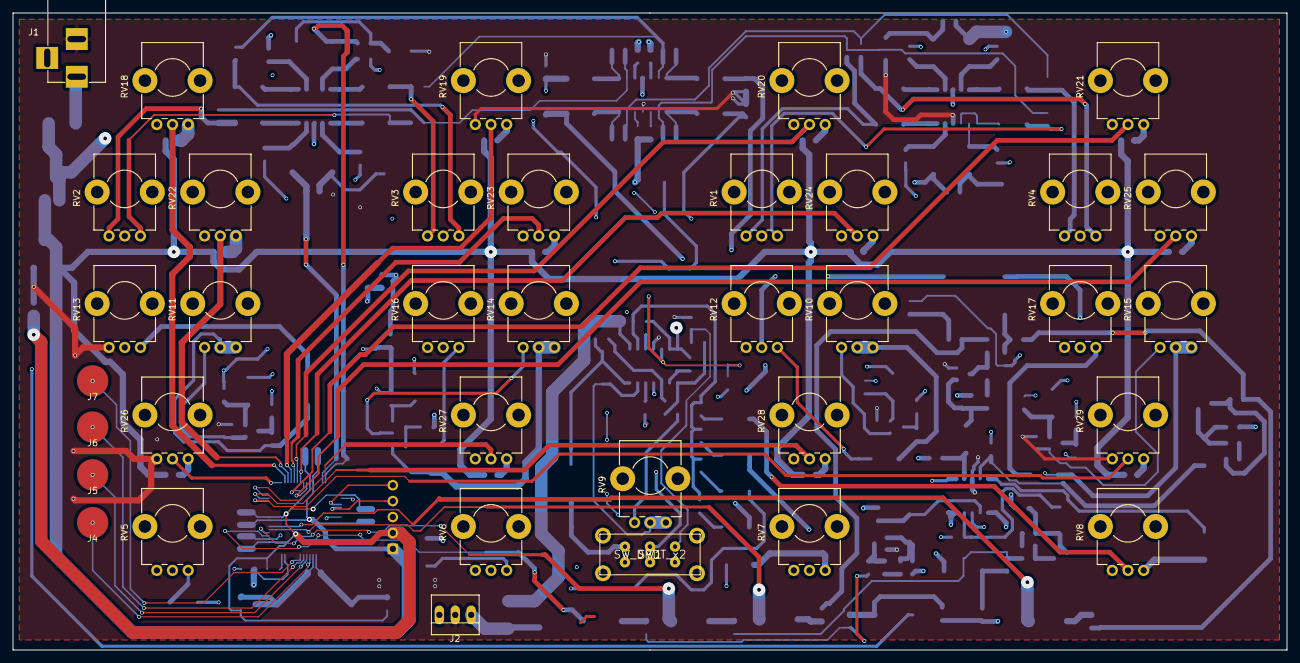
[picture p23: board synth_psoc_v1.kicad_pcb from above]

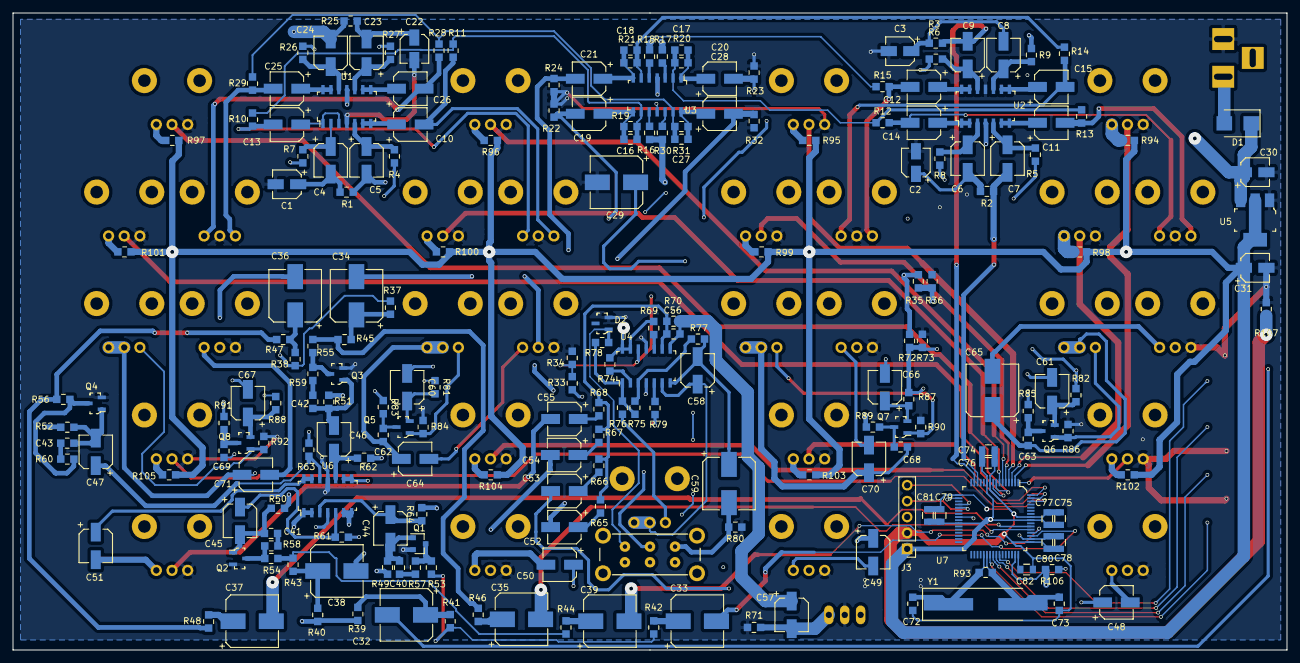
[picture p24: board synth_psoc_v1.kicad_pcb from below]

Board: 4 copper layers, 203.2 x 101.6 mm, 244 parts (208 on the bottom side), 177 nets.

Parts:
C1, C2, C3, C22, C30: 1uF; CP_Elec_4x4.5
C4, C5, C6, C7, C8, C9, C10, C11, C12, C13, C14, C15, C19, C20, C21, C23, C24, C25, C26, C28, C44, C45, C46, C47, C48, C49, C50, C51, C52, C53, C54, C55, C57, C58, C60, C61, C64, C66, C67, C70, C71: 22uF; CP_Elec_5x5.7
C16, C17, C18, C27: 100p; 0805
C29, C59, C65: 220uF; CP_Elec_8x10
C31: 4.7uF; CP_Elec_4x5.7
C32, C33, C34, C35, C36, C37, C38, C39: 220u; CP_Elec_8x10
C40, C41, C42, C43: 1nF; 0805
C56: 100pF; 0805
C62, C63, C68, C69: 33nF; 0805
C72, C73: 22pF; 0805
C74, C75, C78, C81, C82: 1uF; C_0805
C76, C77, C79, C80: 0.1uF; C_0805
D1: D_Schottky; D_SMB
D2: BZX84C3V3-T1; SOT-23-3
J1: Barrel_Jack; BARREL_JACK
J2: Audio-Jack-2_Switch; PINHEAD1-3
J3: SWD_programming; Pin_Header_Straight_1x05_Pitch2.54mm
J4: Capsense_0; Capsense_button
J5: Capsense_1; Capsense_button
J6: Capsense_2; Capsense_button
J7: Capsense_3; Capsense_button
Q1: MMBFJ177; SOT-23
Q2, Q3, Q4: MMBFJ177; SOT-23-3
Q5, Q6, Q7, Q8: 2N3904; SOT-23-3
R1, R2, R3, R25: 1k; 0805
R4, R5, R6, R7, R8, R9, R16, R17, R18, R26, R27, R30, R37, R38, R39, R40, R61, R62, R63, R64, R69, R74, R79, R81, R82, R87, R88: 470k; 0805
R10, R11, R12, R13, R14, R15, R19, R20, R21, R28, R29, R31, R65, R66, R67, R68, R70, R71, R72, R73, R75, R83, R84, R85, R86, R89, R90, R91, R92: 10k; 0805
R22, R23, R24, R32, R33, R34, R80: 100k; 0805
R35, R36, R49, R50, R51, R52: 22k; 0805
R41, R43, R45, R47, R53, R54, R55, R56, R57, R58, R59, R60, R93: 1MEG; 0805
R42, R44, R46, R48: 500k; 0805
R76: 470; 0805
R77: 2.2k; 0805
R78: 860; 0805
R94, R95, R96, R97, R98, R99, R100, R101, R102, R103, R104, R105, R106, R107: R; 0805
RV1, RV2, RV3, RV4: 100k-S; Potentiometer_Bourns_PTV09A-1_Horizontal
RV5, RV6, RV7, RV8: 100k; Potentiometer_Bourns_PTV09A-1_Horizontal
RV9, RV12, RV13, RV16, RV17: 10kA; Potentiometer_Bourns_PTV09A-1_Horizontal
RV10, RV11, RV14, RV15: 10kB; Potentiometer_Bourns_PTV09A-1_Horizontal
RV18, RV19, RV20, RV21, RV22, RV23, RV24, RV25: 20kA; Potentiometer_Bourns_PTV09A-1_Horizontal
RV26, RV27, RV28, RV29: 20kB; Potentiometer_Bourns_PTV09A-1_Horizontal
SW1: SW_DPDT_x2; SWITCHE-DPDT
U1, U2, U3, U4, U6: TL074; SOIC-14_W3.9mm
U5: LD1117S33CTR; SOT-223
U7: CY8C4246AZI-L445; LQFP-64_10x10mm
Y1: Crystal; Crystal_SMD_HC49-SD_HandSoldering

Connections:
+3V3: C31.1, C74.1, C75.1, C76.1, C77.1, C78.1, C79.1, C80.1, C81.1, J3.1, R94.1, R95.1, R96.1, R97.1, R98.1, R99.1, R100.1, R101.1, R102.1, R103.1, R104.1, R105.1, R106.1, U5.2, U5.4, U7.11, U7.26, U7.50, U7.56
+15V: C30.1, D1.1, R33.1, R35.2, R72.1, R83.1, R85.1, R89.1, R91.1, U1.11, U2.4, U3.4, U4.4, U5.3, U6.4
/Envelope/env_out_1: C52.2, RV5.2
/Envelope/env_out_2: C53.2, RV6.2
/Envelope/env_out_3: C54.2, RV7.2
/Envelope/env_out_4: C55.2, RV8.2
/Envelope/lfo1: C32.2, RV13.2
/Envelope/lfo2: C38.2, RV16.2
/Envelope/lfo3: C34.2, RV12.2
/Envelope/lfo4: C36.2, RV17.2
/Envelope/lfo_bias: R35.1, R36.2, R37.1, R38.1, R39.1, R40.1
/Filters/filter_out_1: C20.2, R23.1, R49.2
/Filters/filter_out_2: C21.2, R24.1, R50.2
/Filters/filter_out_3: C19.2, R22.1, R51.2
/Filters/filter_out_4: C28.2, R32.1, R52.2
/Filters/osc1: C7.2, R2.2, U7.14
/Filters/osc2: C9.2, R3.2, U7.15
/Filters/osc3: C5.2, R1.2, U7.18
/Filters/osc4: C24.2, R25.2, U7.24
/LFO Modulation and Routing/bias: R72.2, R73.1, R81.1, R82.1, R87.1, R88.1
/LFO Modulation and Routing/lfo_square: D2.1, R78.1, SW1.3
/LFO Modulation and Routing/lfo_tri: C59.2, R80.2, SW1.1
/LFO Modulation and Routing/main_lfo: C60.2, C61.2, C66.2, C67.2, SW1.2
/Microcontroller/SCLK: J3.4, U7.21
/Microcontroller/SDAT: J3.5, U7.20
/Microcontroller/XRES: J3.3, R106.2, U7.47
/Microcontroller/envelope_pwm_1: C33.2, U7.51
/Microcontroller/envelope_pwm_2: C39.2, U7.52
/Microcontroller/envelope_pwm_3: C35.2, U7.53
/Microcontroller/envelope_pwm_4: C37.2, U7.54
/Microcontroller/osc1_freq_wiper: RV18.2, U7.2
/Microcontroller/osc1_pwm_wiper: RV22.2, U7.3
/Microcontroller/osc1_speed: RV26.2, U7.1
/Microcontroller/osc2_freq_wiper: RV19.2, U7.4
/Microcontroller/osc2_pwm_wiper: RV23.2, U7.5
/Microcontroller/osc2_speed: RV27.2, U7.64
/Microcontroller/osc3_freq_wiper: RV20.2, U7.6
/Microcontroller/osc3_pwm_wiper: RV24.2, U7.7
/Microcontroller/osc3_speed: RV28.2, U7.63
/Microcontroller/osc4_freq_wiper: RV21.2, U7.8
/Microcontroller/osc4_pwm_wiper: RV25.2, U7.9
/Microcontroller/osc4_speed: RV29.2, U7.62
GND: C1.2, C2.2, C3.2, C22.2, C29.2, C30.2, C31.2, D2.2, J1.2, J2.2, Q1.2, Q2.2, Q3.2, Q4.2, R22.2, R23.2, R24.2, R32.2, R34.2, R36.1, R71.1, R73.2, R80.1, R84.2, R86.2, R90.2, R92.2, R107.1, RV1.2, RV2.2, RV3.2, RV4.2, RV5.3, RV6.3, RV7.3, RV8.3, RV12.3, RV13.3, RV16.3, RV17.3, RV18.3, RV19.3, RV20.3, RV21.3, RV22.3, RV23.3, RV24.3, RV25.3, RV26.3, RV27.3, RV28.3, RV29.3, U1.4, U2.11, U3.11, U4.11, U5.1, U6.11
GNDD: C72.2, C73.2, C74.2, C75.2, C76.2, C77.2, C78.2, C79.2, C80.2, C81.2, C82.2, J3.2, R107.2, U7.10, U7.17, U7.49, U7.57
unnamed: C1.1, C4.2, R1.1
unnamed: C2.1, C6.2, R2.1
unnamed: C3.1, C8.2, R3.1
unnamed: C4.1, R7.2, U1.2
unnamed: C5.1, R4.2, U1.5
unnamed: C6.1, R8.2, U2.3
unnamed: C7.1, R5.2, U2.5
unnamed: C8.1, R9.2, U2.10
unnamed: C9.1, R6.2, U2.12
unnamed: C10.1, U1.6, U1.7
unnamed: C10.2, R11.2, RV1.3
unnamed: C11.1, U2.6, U2.7
unnamed: C11.2, R13.2, RV2.3
unnamed: C12.1, U2.13, U2.14
unnamed: C12.2, R15.2, RV3.3
unnamed: C13.1, U1.1, U1.3
unnamed: C13.2, R10.2, RV1.1
unnamed: C14.1, U2.1, U2.2
unnamed: C14.2, R12.2, RV2.1
unnamed: C15.1, U2.8, U2.9
unnamed: C15.2, R14.2, RV3.1
unnamed: C16.1, C19.1, R19.1, U3.8
unnamed: C16.2, R10.1, R11.1, R19.2, U3.9
unnamed: C17.1, C20.1, R20.1, U3.1
unnamed: C17.2, R12.1, R13.1, R20.2, U3.2
unnamed: C18.1, C21.1, R21.1, U3.7
unnamed: C18.2, R14.1, R15.1, R21.2, U3.6
unnamed: C22.1, C23.2, R25.1
unnamed: C23.1, R27.2, U1.10
unnamed: C24.1, R26.2, U1.12
unnamed: C25.1, U1.13, U1.14
unnamed: C25.2, R29.2, RV4.3
unnamed: C26.1, U1.8, U1.9
unnamed: C26.2, R28.2, RV4.1
unnamed: C27.1, C28.1, R31.1, U3.14
unnamed: C27.2, R28.1, R29.1, R31.2, U3.13
unnamed: C29.1, R33.2, R34.1, U4.12
unnamed: C32.1, R39.2, R41.2
unnamed: C33.1, R42.2
unnamed: C34.1, R37.2, R45.2
unnamed: C35.1, R46.2
unnamed: C36.1, R38.2, R47.2
unnamed: C37.1, R48.2
unnamed: C38.1, R40.2, R43.2
unnamed: C39.1, R44.2
unnamed: C40.1, R57.2
unnamed: C40.2, C44.2, Q1.1, R49.1
unnamed: C41.1, R58.2
unnamed: C41.2, C45.2, Q2.1, R50.1
unnamed: C42.1, R59.2
unnamed: C42.2, C46.2, Q3.1, R51.1
unnamed: C43.1, R60.2
unnamed: C43.2, C47.2, Q4.1, R52.1
unnamed: C44.1, R64.1, U6.3
unnamed: C45.1, R61.1, U6.5
unnamed: C46.1, R62.1, U6.10
unnamed: C47.1, R63.1, U6.12
unnamed: C48.1, U6.1, U6.2
unnamed: C48.2, RV5.1
unnamed: C49.1, U6.6, U6.7
unnamed: C49.2, RV6.1
unnamed: C50.1, U6.8, U6.9
unnamed: C50.2, RV7.1
unnamed: C51.1, U6.13, U6.14
unnamed: C51.2, RV8.1
unnamed: C52.1, R65.2
unnamed: C53.1, R66.2
unnamed: C54.1, R67.2
unnamed: C55.1, R68.2
unnamed: C56.1, C57.1, R70.1, U4.8
unnamed: C56.2, R65.1, R66.1, R67.1, R68.1, R70.2, U4.9
unnamed: C57.2, J2.1, R71.2
unnamed: C58.1, RV9.1, RV9.2, U4.6
unnamed: C58.2, C59.1, R77.1, U4.7
unnamed: C60.1, Q5.2, R81.2
unnamed: C61.1, Q6.2, R82.2
unnamed: C62.1, Q5.3, R83.2
unnamed: C62.2, C64.1, RV10.1, RV10.2
unnamed: C63.1, Q6.3, R85.2
unnamed: C63.2, C65.1, RV11.1, RV11.2
unnamed: C64.2, RV12.1
unnamed: C65.2, RV13.1
unnamed: C66.1, Q7.2, R87.2
unnamed: C67.1, Q8.2, R88.2
unnamed: C68.1, Q7.3, R89.2
unnamed: C68.2, C70.1, RV14.1, RV14.2
unnamed: C69.1, Q8.3, R91.2
unnamed: C69.2, C71.1, RV15.1, RV15.2
unnamed: C70.2, RV16.1
unnamed: C71.2, RV17.1
unnamed: C72.1, R93.2, U7.37, Y1.1
unnamed: C73.1, R93.1, U7.38, Y1.2
unnamed: C82.1, U7.48
unnamed: D1.2, J1.1
unnamed: J4.1, U7.39
unnamed: J5.1, U7.40
unnamed: J6.1, U7.41
unnamed: J7.1, U7.42
unnamed: Q1.3, R53.1, R57.1
unnamed: Q2.3, R54.1, R58.1
unnamed: Q3.3, R55.1, R59.1
unnamed: Q4.3, R56.1, R60.1
unnamed: Q5.1, R84.1, RV10.3
unnamed: Q6.1, R86.1, RV11.3
unnamed: Q7.1, R90.1, RV14.3
unnamed: Q8.1, R92.1, RV15.3
unnamed: R16.1, U3.10
unnamed: R17.1, U3.3
unnamed: R18.1, U3.5
unnamed: R30.1, U3.12
unnamed: R41.1, R42.1, R53.2
unnamed: R43.1, R44.1, R54.2
unnamed: R45.1, R46.1, R55.2
unnamed: R47.1, R48.1, R56.2
unnamed: R69.1, U4.10
unnamed: R74.1, U4.2
unnamed: R75.1, R76.2, R78.2, U4.1
unnamed: R75.2, R77.2, U4.3
unnamed: R76.1, RV9.3
unnamed: R79.1, U4.5
unnamed: R94.2, RV18.1
unnamed: R95.2, RV19.1
unnamed: R96.2, RV20.1
unnamed: R97.2, RV21.1
unnamed: R98.2, RV22.1
unnamed: R99.2, RV23.1
unnamed: R100.2, RV24.1
unnamed: R101.2, RV25.1
unnamed: R102.2, RV26.1
unnamed: R103.2, RV27.1
unnamed: R104.2, RV28.1
unnamed: R105.2, RV29.1
VREF: R4.1, R5.1, R6.1, R7.1, R8.1, R9.1, R16.2, R17.2, R18.2, R26.1, R27.1, R30.2, R61.2, R62.2, R63.2, R64.2, R69.2, R74.2, R79.2, U4.13, U4.14
