pmusgrave/synth_psoc/Firmware/synth_psoc.cydsn/main.c

#include "project.h"
#include "interrupts.h"
#include "globals.h"
#include "oscillator.h"
#include "buttons.h"

#define FREQ_0_ADC_CHAN 0
#define PW_0_ADC_CHAN 1
#define FREQ_1_ADC_CHAN 2
#define PW_1_ADC_CHAN 3
#define FREQ_2_ADC_CHAN 4
#define PW_2_ADC_CHAN 5
#define FREQ_3_ADC_CHAN 6
#define PW_3_ADC_CHAN 7
#define ENV_MUX_ADC_CHAN 8

#define ENVELOPE_MAX_PERIOD 2048

/*******************************************************************************
* Global Variables
*******************************************************************************/
volatile uint8_t adc_update_flag = 0;

volatile struct oscillator Osc_0 = {0, 0, &osc_0_quant_Read};
volatile struct oscillator Osc_1 = {0, 0, &osc_1_quant_Read};
volatile struct oscillator Osc_2 = {0, 0, &osc_2_quant_Read};
volatile struct oscillator Osc_3 = {0, 0, &osc_3_quant_Read};

volatile struct envelope Osc_0_Envelope = {0, 0};
volatile struct envelope Osc_1_Envelope = {0, 0};
volatile struct envelope Osc_2_Envelope = {0, 0};
volatile struct envelope Osc_3_Envelope = {0, 0};

struct button Osc_0_Button = {&osc_0_hold_Read, &osc_0_repeat_Read, 0, 0, CapSense_Buttons_BUTTON0__BTN, &main_osc_PWM_0_Start, &main_osc_PWM_0_Stop};
struct button Osc_1_Button = {&osc_1_hold_Read, &osc_1_repeat_Read, 0, 0, CapSense_Buttons_BUTTON1__BTN, &main_osc_PWM_1_Start, &main_osc_PWM_1_Stop};
struct button Osc_2_Button = {&osc_2_hold_Read, &osc_2_repeat_Read, 0, 0, CapSense_Buttons_BUTTON2__BTN, &main_osc_PWM_2_Start, &main_osc_PWM_2_Stop};
struct button Osc_3_Button = {&osc_3_hold_Read, &osc_3_repeat_Read, 0, 0, CapSense_Buttons_BUTTON3__BTN, &main_osc_PWM_3_Start, &main_osc_PWM_3_Stop};

/*******************************************************************************
* USB and MIDI stuff
* references Cypress MIDI code examples
*******************************************************************************/
#define DEVICE                  (0u)
#define MIDI_MSG_SIZE           (4u)

/*MIDI Message Fields */
#define MIDI_MSG_TYPE           (0u)
#define MIDI_NOTE_NUMBER        (1u)
#define MIDI_NOTE_VELOCITY      (2u)

/* Identity Reply message */
const uint8 CYCODE MIDI_IDENTITY_REPLY[] = {
    0xF0u,      /* SysEx */
    0x7Eu,      /* Non-real time */
    0x7Fu,      /* ID of target device (7F - "All Call") */
    0x06u,      /* Sub-ID#1 - General Information */
    0x02u,      /* Sub-ID#2 - Identity Reply */
    0x7Du,      /* Manufacturer's ID: 7D - Educational Use */
    0xB4u, 0x04u,               /* Family code */
    0x32u, 0xD2u,               /* Model number */
    0x01u, 0x00u, 0x00u, 0x00u, /* Version number */
    /*0xF7         End of SysEx automatically appended */
};

/* Need for Identity Reply message */
volatile uint8 USB_MIDI1_InqFlags;

volatile uint8 usbActivityCounter = 0u;

uint8 inqFlagsOld = 0u;

uint8 midiMsg[MIDI_MSG_SIZE];   
char buff[32];//output UART buffer

// volatile uint8_t MIDI_RX_flag = 0;


/*******************************************************************************
* Function Prototypes
*******************************************************************************/

void UpdateADCValues(uint8_t *AMux_ADC);
void UpdateOscFreq(volatile struct oscillator *oscillator, struct button *button, uint8_t ADC_chan);
void UpdateOscPulseWidth(volatile struct oscillator *oscillator, uint8_t ADC_chan);
void UpdateEnvelope(volatile struct envelope *envelope, struct button *button);

/******************************************************************************/

int main(void)
{
    CyGlobalIntEnable;

    // Start all ADC components
    ADC_SAR_Seq_Start();
    ADC_SAR_Seq_StartConvert();
    ADC_EOC_INT_StartEx(ADC_EOC);
    CyDelayUs(10);
    
    // Init main oscillator PWM components
    EnableAllOscillators();
    
    // Init interrupts to change PWM values on overflow
    osc_0_ovf_StartEx(OSC_0_OVF_VECT);
    osc_1_ovf_StartEx(OSC_1_OVF_VECT);
    osc_2_ovf_StartEx(OSC_2_OVF_VECT);
    osc_3_ovf_StartEx(OSC_3_OVF_VECT);
    
    // Init envelope components and PWM interrupts
    envelope_PWM_0_Start();
    envelope_PWM_1_Start();
    envelope_PWM_2_Start();
    envelope_PWM_3_Start();
    
    envelope_0_ovf_StartEx(ENV_0_OVF_VECT);
    envelope_1_ovf_StartEx(ENV_1_OVF_VECT);
    envelope_2_ovf_StartEx(ENV_2_OVF_VECT);
    envelope_3_ovf_StartEx(ENV_3_OVF_VECT);
    
    AMux_Start();
    AMux_Init();
    Opamp_Start();
    uint8_t AMux_ADC_counter = 0;
    
    // Init Capsense
    CapSense_Buttons_Start();	
	CapSense_Buttons_InitializeAllBaselines();
    CapSense_Buttons_ScanEnabledWidgets();
    
    // Init USB and MIDI
    // references Cypress USB MIDI code example
    USB_Start(DEVICE, USB_DWR_VDDD_OPERATION); 
    //MIDI1_UART_Start();
    //MIDI_RX_StartEx(MIDI_RX_VECT);
    
    CyDelayUs(1000);
    
    while(1){
        if(adc_update_flag != 0) { 
            adc_update_flag = 0;
            UpdateADCValues(&AMux_ADC_counter);
        }

        UpdateEnvelope(&Osc_0_Envelope, &Osc_0_Button);
        UpdateEnvelope(&Osc_1_Envelope, &Osc_1_Button);
        UpdateEnvelope(&Osc_2_Envelope, &Osc_2_Button);
        UpdateEnvelope(&Osc_3_Envelope, &Osc_3_Button);
       
        // scan all CapSense buttons sequentially,
        // and start oscillator if button is pressed
        if(!CapSense_Buttons_IsBusy()) {
            CapSense_Buttons_UpdateEnabledBaselines();
            
            HandleButton(&Osc_0_Button);
            HandleButton(&Osc_1_Button);
            HandleButton(&Osc_2_Button);
            HandleButton(&Osc_3_Button);
            
            CapSense_Buttons_ScanEnabledWidgets();
        }
        
        /*******************************************************************************
        * USB AND MIDI STUFF
        * references Cypress USB MIDI code examples
        *******************************************************************************/
        if(0u != USB_IsConfigurationChanged()){
            if(0u != USB_GetConfiguration())   // Initialize IN endpoints when device configured
            {
                USB_MIDI_Init(); // Enable output endpoint
            }
        }            
        
        /* Service USB MIDI when device is configured */
        if(0u != USB_GetConfiguration())    
        {
            /* Call this API from UART RX ISR for Auto DMA mode */
            #if(!USB_EP_MANAGEMENT_DMA_AUTO) 
                USB_MIDI_IN_Service();
            #endif
            /* In Manual EP Memory Management mode OUT_EP_Service() 
            *  may have to be called from main foreground or from OUT EP ISR
            */
            #if(!USB_EP_MANAGEMENT_DMA_AUTO) 
                USB_MIDI_OUT_Service();
            #endif

            /* Sending Identity Reply Universal System Exclusive message 
             * back to computer */
            if(0u != (USB_MIDI1_InqFlags & USB_INQ_IDENTITY_REQ_FLAG))
            {
                USB_PutUsbMidiIn(sizeof(MIDI_IDENTITY_REPLY), (uint8 *)MIDI_IDENTITY_REPLY, USB_MIDI_CABLE_00);
                USB_MIDI1_InqFlags &= ~USB_INQ_IDENTITY_REQ_FLAG;
            }
        }
    }
}

void UpdateADCValues(uint8_t *AMux_ADC){
    UpdateOscFreq(&Osc_0, &Osc_0_Button, FREQ_0_ADC_CHAN);
    UpdateOscPulseWidth(&Osc_0, PW_0_ADC_CHAN);
  
    UpdateOscFreq(&Osc_1, &Osc_1_Button, FREQ_1_ADC_CHAN);
    UpdateOscPulseWidth(&Osc_1, PW_1_ADC_CHAN);
    
    UpdateOscFreq(&Osc_2, &Osc_2_Button, FREQ_2_ADC_CHAN);
    UpdateOscPulseWidth(&Osc_2, PW_2_ADC_CHAN);
    
    UpdateOscFreq(&Osc_3,&Osc_3_Button,  FREQ_3_ADC_CHAN);
    UpdateOscPulseWidth(&Osc_3, PW_3_ADC_CHAN);

    
    // envelope
    AMux_Select(*AMux_ADC);
    CyDelayUs(30);
    switch(*AMux_ADC){
    case 0:
        Osc_0_Envelope.env_speed = ADC_SAR_Seq_GetResult16(ENV_MUX_ADC_CHAN);
    case 1:
        Osc_1_Envelope.env_speed = ADC_SAR_Seq_GetResult16(ENV_MUX_ADC_CHAN);
    case 2:
        Osc_2_Envelope.env_speed = ADC_SAR_Seq_GetResult16(ENV_MUX_ADC_CHAN);
    case 3:
        Osc_3_Envelope.env_speed = ADC_SAR_Seq_GetResult16(ENV_MUX_ADC_CHAN);
    }
    (*AMux_ADC) += 1;
    if (*AMux_ADC == 4){
        *AMux_ADC = 0;
    }
    CyDelayUs(30);
}

void UpdateOscFreq(volatile struct oscillator *oscillator, struct button *button, uint8_t ADC_chan){
    if((*button).MIDI_triggered == 0){
        (*oscillator).freq = ADC_SAR_Seq_GetResult16(ADC_chan);
        if((*oscillator).quant_check_function() == 1){
            (*oscillator).freq = Quantize((*oscillator).freq);
        }
    }
}

void UpdateOscPulseWidth(volatile struct oscillator *oscillator, uint8_t ADC_chan){
    (*oscillator).pulse_width = ADC_SAR_Seq_GetResult16(ADC_chan); 
}

void UpdateEnvelope(volatile struct envelope *envelope, struct button *button){
    if((*envelope).env_speed < 50){
        (*envelope).env_speed = 50;
    }
    if((*button).note_triggered == 1 || (*button).MIDI_triggered == 1){
        (*envelope).env_pwm = (*envelope).env_pwm + (*envelope).env_speed;
        if( (*button).repeat_check_function() || !(*button).hold_check_function()){
            if ((*envelope).env_pwm > 65000) {
                (*envelope).env_pwm  = 65000;
            }
        }
    }
   else {
        if((*envelope).env_pwm > 1){
            (*envelope).env_pwm = (*envelope).env_pwm - (*envelope).env_speed;
        }
        if ((*envelope).env_pwm < 1){
            (*button).osc_disable_function();
        }
    }
}

/*******************************************************************************
* Function Name: USB_callbackLocalMidiEvent
********************************************************************************
* Summary: Local processing of the USB MIDI out-events.
* References: Cypress code examples, 
* and https://community.cypress.com/message/144752#144752
*******************************************************************************/
void USB_callbackLocalMidiEvent(uint8 cable, uint8 *midiMsg) CYREENTRANT
{
    uint8 note;
    
    /* Support General System On/Off Message. */
    /*
    if((0u == (USB_MIDI1_InqFlags & USB_INQ_SYSEX_FLAG)) \
            && (0u != (inqFlagsOld & USB_INQ_SYSEX_FLAG)))
    {
        if(midiMsg[USB_EVENT_BYTE0] == USB_MIDI_SYSEX_GEN_MESSAGE)
        {
            if(midiMsg[USB_EVENT_BYTE1] == USB_MIDI_SYSEX_SYSTEM_ON)
            {
                MIDI_PWR_Write(0u); 
            }
            else if(midiMsg[USB_EVENT_BYTE1] == USB_MIDI_SYSEX_SYSTEM_OFF)
            {
                MIDI_PWR_Write(1u); 
            }
        }
    }
    */
    inqFlagsOld = USB_MIDI1_InqFlags;
    cable = cable;
    
    if (midiMsg[USB_EVENT_BYTE0] == USB_MIDI_NOTE_ON)
    {
        note = midiMsg[USB_EVENT_BYTE1];
        DispatchNote(note);
    }
    else if (midiMsg[USB_EVENT_BYTE0] == USB_MIDI_NOTE_OFF)
    {
        note = midiMsg[USB_EVENT_BYTE1];
        NoteOff(note);
    }
}    


/*******************************************************************************
* Function Name: USB_MIDI1_ProcessUsbOut_EntryCallback
********************************************************************************
* Summary:  Turn the LED_OutA on at the beginning of the function
* USB_MIDI1_ProcessUsbOut() when data comes to be put in the UART1 out
* buffer.
* 
*******************************************************************************/
void USB_MIDI1_ProcessUsbOut_EntryCallback(void)
{
    //LED_OutA_Write(1);
}


/*******************************************************************************
* Function Name: USB_MIDI1_ProcessUsbOut_ExitCallback
********************************************************************************
* Summary:  Turn the LED_OutA off at the end of the function  
* USB_MIDI1_ProcessUsbOut() when data is put in the UART1 out-buffer.
* 
*******************************************************************************/
void USB_MIDI1_ProcessUsbOut_ExitCallback(void)
{
    //LED_OutA_Write(0);
}

/*******************************************************************************
* Function Name: MIDI1_UART_RXISR_EntryCallback
********************************************************************************
* Summary:  Turn the LED_InA on at the beginning of the MIDI1_UART_RXISR ISR  
* when data comes to UART1 to be put in the USBFS_MIDI IN endpoint
* buffer.
*
*******************************************************************************/
void MIDI1_UART_RXISR_EntryCallback(void)
{
    /* These LEDs indicate MIDI input activity */
    //LED_InA_Write(1);
}


/*******************************************************************************
* Function Name: MIDI1_UART_RXISR_ExitCallback
********************************************************************************
* Summary:  Turn the LED_InA off at the end of the MIDI1_UART_RXISR ISR  
* when data is put in the USBFS_MIDI IN endpoint buffer.
*
*******************************************************************************/
void MIDI1_UART_RXISR_ExitCallback(void)
{
    #if (USB_EP_MANAGEMENT_DMA_AUTO) 
        USB_MIDI_IN_Service();
    #endif /* (USB_EP_MANAGEMENT_DMA_AUTO) */
    
    //LED_InA_Write(0);
}

/* [] END OF FILE */
