pmusgrave/synth_psoc/(commit log)

2018-07-17 add hardware for ADSR pin configuration subject to change but this is current potentiometer setup on dev board
2018-07-17 add envelope trigger switch debounced interrupt connected to switch input currently toggling an LED as a test
2018-07-18 push button to trigger the start of an envelope envelope currently fades an LED up to a value set by the attack pot
2018-07-18 potentiometer sets timer period, which is the correct way to change the slope fixes bug from previous commit
    [main.c]
2018-07-24 ADSR switches between all four modes pushbutton to trigger, stays in sustain mode until another button press green LED indicates sustain mode is active
2018-07-24 make sure timer is 0 at the beginning of new trigger
2018-07-24 starting to prototype LFO with red LED freq currently set by same knob as square wave oscillator
    [main.c]
2019-01-03 oscillator known good state frequency and PWM knobs are both working square wave output is what it should be
    [main.c]
2019-01-03 move oscillator code to separate header and source files for readability
    [interrupts.c, main.c, oscillator.c]
2019-01-03 add 4 debug LEDs to detect current mode
2019-01-03 fixes ADSR mode switching. press button to trigger ADSR, ENABLE_TIMER will switch modes on compare match. Currently, sustain mode can only be exited by a second button press. Time values are correct,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
    [interrupts.c, main.c]
2019-01-04 fixes ADSR ramp. still has some bugs: speed is still too low, probably need to change to log pots, some pot values create a glitch where the timer doesn't overflow and it never changes modes, it jump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
    [interrupts.c, main.c]
2019-01-04 move envelope output to inverted pwm driver for driving the gate of a P-channel FET
    [interrupts.c, main.c]
2019-01-05 initial sawtooth wave is functional, but glitchy
    [interrupts.c, interrupts.h, main.c]
2019-01-05 moved code into Firmware directory and added Hardware directory for electronics documentation
    [synth_psoc.kicad_pcb, synth_psoc.sch]
2019-01-06 testing 2 oscs with a voltage summing circuit. Works great.
2019-01-09 initial schematic commit. create hierarchical sheets for microcontroller and filters
    [mcu.sch, vcf.sch]
2019-01-09 add sheets for the remaining functionality. This should hopefully be all sheets, but might add more if necessary.
    [lfo.sch, mcu.sch, mixer.sch, out.sch, power.sch, synth_psoc.sch, vca.sch, vcf.sch]
2019-01-09 add basic version of VCA for one channel
    [lfo.sch, mcu.sch, mixer.sch, out.sch, power.sch, synth_psoc.kicad_pcb, synth_psoc.sch, vca.sch]
2019-01-09 add all potentiometers for freq and pulse width
    [lfo.sch, mcu.sch, mixer.sch, out.sch, power.sch, synth_psoc.sch, vca.sch, vcf.sch]
2019-01-09 add bill of materials spreadsheet and begin to populate with values
    [BOM.xlsx, lfo.sch, mixer.sch, vca.sch]
2019-01-10 add mcu, crystal, and programming header to schematic
    [BOM.xlsx, lfo.sch, mcu.sch, mixer.sch, out.sch, power.sch, profitability.xlsx, synth_psoc.sch]
2019-01-10 connect frequency potentiometers to mcu
    [mcu.sch, synth_psoc.sch]
2019-01-10 complete wiring of top level schematic hierarchical pages
    [lfo.sch, mcu.sch, mixer.sch, out.sch, synth_psoc.sch, vca.sch, vcf.sch]
2019-01-10 complete filters for all 4 oscs
    [lfo.sch, mcu.sch, vcf.sch]
2019-01-10 add power jack, 3.3V regulator, VREF divider
    [lfo.sch, mcu.sch, mixer.sch, power.sch, vca.sch, vcf.sch]
2019-01-10 add VREF to all single supply op amps
    [lfo.sch, mcu.sch, mixer.sch, power.sch, synth_psoc.sch, vca.sch, vcf.sch]
2019-01-10 change corner frequency of DC blocking caps everywhere they are in use. Updated some simulation files to test filter circuits.
    [lfo.sch, mixer.sch, synth_psoc.sch, vca.sch]
2019-01-11 add analog LFO to schematic
    [lfo.sch, synth_psoc.sch, vcf.sch]
2019-01-11 add bias voltage to LFO control voltage at JFET gate. This is needed because the LFO tri wave has +/- amplitude.
    [vca.sch]
2019-01-11 begin to add taper to potentiometers. I think they're all right, but some tapers may change under test.
    [lfo.sch, mcu.sch, vca.sch]
2019-01-11 add LFO waveshape selector switch
    [lfo.sch]
2019-01-12 4 oscillators are working at once
    [globals.h, interrupts.c, main.c, oscillator.c]
2019-01-12 fix dropout issue with multiple osc voices.
    [envelope_generator.c, interrupts.c, interrupts.h, main.c, oscillator.c]
2019-01-13 add freq and pulse width pots for 8 oscillators. Still needs to be tested on dev board and built, but I wanted to go ahead and add them to the schematic as an option.
    [mcu.sch]
2019-01-13 change GNDA to GND nets everywhere. Not using any ADC, so don't need separate digital and analog grounds.
    [vca.sch]
2019-01-14 add 1Meg + 1nF cap to JFET base to improve biasing linearity.
    [vca.sch]
2019-01-14 start to test CapSense buttons. This should probably be done on a different branch, though, so I'm not going to do very much more on this branch.
2019-01-14 Capsense button enables all oscillators. testing WIP.
    [main.c, oscillator.c]
2019-01-14 change back to 4 oscillators, add speed control. One pot for each oscillator will control both attack and release times simultaneously. This is simpler than a full ADSR for each channel, but still al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
    [mcu.sch]
2019-01-14 mix LFO and Envelope drive signals instead of switching them, and add overall volume mix control to each channel.
    [lfo.sch, vca.sch]
2019-01-14 update pinout with latest changes for production IC
    [mcu.sch]
2019-01-14 associate footprints with all components
    [lfo.sch, mcu.sch, mixer.sch, power.sch, vca.sch, vcf.sch]
2019-01-14 measure positions of potentiometers and tentative board edge definition.
    [_saved_mcu.sch, synth_psoc.kicad_pcb]
2019-01-15 fix annotation and footprints for multi-part op amps.
    [_saved_mcu.sch, lfo.sch, mcu.sch, mixer.sch, power.sch, synth_psoc.kicad_pcb, vcf.sch]
2019-01-15 loosely organize components into groups based on their functionality
    [mcu.sch, profitability.xlsx, synth_psoc.kicad_pcb]
2019-01-15 component placement mostly finalized
    [synth_psoc.kicad_pcb]
2019-01-16 MCU bypass capacitor routing complete
    [mcu.sch, synth_psoc.kicad_pcb]
2019-01-16 gettin' there. WIP
    [mcu.sch, synth_psoc.kicad_pcb]
2019-01-17 complete initial PCB layout. CapSense buttons still not done, but everything else should be there. I had to increase to a 4-layer board to keep the dimensions 8"x4".
    [power.sch, synth_psoc.kicad_pcb, vca.sch, vcf.sch]
2019-01-17 complete PCB v1, no DRC errors.
    [mcu.sch, synth_psoc.kicad_pcb]
2019-01-17 as built v1 boards, 2019-01-16 with gerber outputs
    [synth_psoc-B.Cu.gbr, synth_psoc-B.Mask.gbr, synth_psoc-B.SilkS.gbr, synth_psoc-Edge.Cuts.gbr, synth_psoc-F.Cu.gbr, synth_psoc-F.Mask.gbr, synth_psoc-F.SilkS.gbr, synth_psoc-In1.Cu.gbr]
2019-01-17 some basic planning on price point, sales, and profitability.
    [profitability.xlsx]
2019-01-17 add envelope speed ADC inputs to firmware
2019-01-17 scan all 4 capsense buttons and enable oscillators independently. Also did some refactoring of the oscillator module and main.
    [globals.h, interrupts.c, main.c, oscillator.c]
2019-01-18 move capsense button conditionals into a function. Arguments are the capsense widget to be checked, a function pointer to the start and stop functions for the corresponding oscillator. This could pro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
    [buttons.c, main.c, oscillator.c]
2019-01-18 change osc speed controls to digital inputs. These will be switches on the prototype, because I don't have enough timers for 4 envelope PWMs, but made them that way on the board.
2019-01-18 fix missing connection of envelope outputs on MCU schematic page
    [mcu.sch]
2019-01-25 some fixes from v1 boards. Power and GND are switched on one of the TL074s, fix an error in pot net connections. change firmware pinout to match boards. probably other minor things?
    [mcu.sch, vcf.sch]
2019-01-30 fix some bias voltage issues in the LFO schematic. Also begin working on envelope firmware, but this is in progress.
    [lfo.sch, vcf.sch]
2019-01-30 define notes as preprocessor macros. This is going to change, but I don't want to have to redo any of it in case I need it.
2019-01-30 add LPF to envelope PWM signals, and some test code for ramping up the PWM out of the micro.
    [mcu.sch]
2019-01-31 temporarily use PW pot for envelope attack/release time. Multiplying adc reading by 0.002 as an envelope increment works well experimentally.
2019-01-31 add Cmod cap to microcontroller for capsense operation.
    [mcu.sch]
2019-01-31 simulate correct corner frequency for new LPF circuit.
    [_saved_vcf.sch]
2019-01-31 change LPF to sallen key filters.
    [_saved_vcf.sch, vcf.sch]
2019-01-31 change 3.3V to 5V, fix LFO biasing, LPF, JFET bias trim pots.
    [lfo.sch, mcu.sch, power.sch, vca.sch]
2019-01-31 add quantization switches
    [mcu.sch, power.sch, vca.sch]
2019-01-31 add LPF to envelope PWM outputs
    [mcu.sch]
2019-01-31 add envelope repeat switches
    [mcu.sch]
2019-02-01 simulate bias voltage buffer. Previous op amp approach couldn't go close enough to the rails.
    [mcu.sch, mixer.sch, synth_psoc.sch]
2019-02-01 update schematics with NPN bias buffer
    [vca.sch]
2019-02-01 add initial delay schematic based on PT2399 application circuit.
    [mixer.sch]
2019-02-01 add delay mix control. Currently 50/50 is max possible wet/dry, but this might change.
    [vcf.sch]
2019-02-01 fix quantization range by pre-computing the conversion from note frequencies to their corresponding ADC values.
    [oscillator.c]
2019-02-01 quantize all 4 oscillators for now
    [main.c]
2019-02-01 add upper bound for envelopes so they don't overflow. This will be an option via panel switch to allow repeated notes.
2019-02-05 change delay summing to balance control to allow 0-100% wet signal, rather than 0-50%.
    [mcu.sch, mixer.sch]
2019-02-05 change emitter resistors on JFET bias buffers
    [vca.sch]
2019-02-07 begin PCB v2 layout. fix ref designators, associate footprints on new components, create new PCB file, import components.
    [_saved_mixer.sch, lfo.sch, mcu.sch, mixer.sch, power.sch, synth_psoc.kicad_pcb, synth_psoc_v1.kicad_pcb, vca.sch]
2019-02-07 add separate Kicad project for control board. There will now be a separate board for all potentiometers and switches with no other components. Also add connectors between boards.
    [control_board.kicad_pcb, control_board.sch, lfo.sch, mcu.sch, mixer.sch, out.sch, power.sch, synth_psoc.csv]
2019-02-07 add control board connects to main synth schematic
    [connectors.sch, lfo.sch, mcu.sch, mixer.sch, power.sch, synth_psoc.sch, vca.sch, vcf.sch]
2019-02-08 add +5V connection to pots on control board
    [control_board.sch]
2019-02-08 connect control board to main synth schem pages
    [connectors.sch, control_board.sch, lfo.sch, mcu.sch, synth_psoc.sch, vcf.sch]
2019-02-08 add connectors for capsense buttons and LFO shape switch
    [control_board.sch, lfo.sch, mcu.sch]
2019-02-09 remove extraneous net labels
    [connectors.sch, lfo.sch, mcu.sch, synth_psoc.sch]
2019-02-09 fix missing connectors in main synth project
    [connectors.sch]
2019-02-09 create initial panel artwork design and update the BOM with some mechanical items.
    [BOM.xlsx]
2019-02-09 reduce drill size on panel artwork and add intermod switch
2019-02-09 move vol knobs to bottom, put switches together above vol knobs. Not sure about this layout. Might want to revert this one.
2019-02-09 add key up/down switches to panel layout
2019-02-11 place potentiometers on control board. Some pots are missing from the control board schematic.
    [_saved_control_board.sch, control_board.kicad_pcb]
2019-02-11 add volume pots to control board
    [_saved_control_board.sch, control_board.kicad_pcb, control_board.sch, vca.sch]
2019-02-11 place MCU footprints
    [_saved_synth_psoc.sch, control_board.kicad_pcb, control_board.sch, synth_psoc.kicad_pcb]
2019-02-11 place delay and output mixer footprints
    [_saved_connectors.sch, _saved_mcu.sch, synth_psoc.kicad_pcb]
2019-02-11 remove external pull-up resistors on digital input pins. These are unecessary due to internal pull-up resistors.
    [_saved_connectors.sch, _saved_mcu.sch, _saved_synth_psoc.sch, connectors.sch, lfo.sch, mcu.sch, mixer.sch, vca.sch]
2019-02-11 place LFO footprints
    [synth_psoc.kicad_pcb]
2019-02-12 place filter footprints
    [synth_psoc.kicad_pcb]
2019-02-12 place envelope footprints. all footprints loosely grouped together.
    [connectors.sch, lfo.sch, mcu.sch, synth_psoc.kicad_pcb]
2019-02-12 add LFO mod pots to control board and fix pot placement
    [control_board.kicad_pcb, control_board.sch, synth_psoc.kicad_pcb]
2019-02-12 route traces to bypass caps on MCU. control board and connectors are WIP.
    [_saved_lfo.sch, _saved_vca.sch, control_board.kicad_pcb, control_board.sch, synth_psoc.kicad_pcb]
2019-02-13 route connectors on control board. Will add additional set of connectors for filter knobs to simplify routing.
    [_saved_lfo.sch, _saved_vca.sch, connectors.sch, control_board.kicad_pcb, control_board.sch, lfo.sch, mcu.sch, synth_psoc.kicad_pcb]
2019-02-13 fix SPDT hold/repeat switches on control board
    [control_board.kicad_pcb, control_board.sch]
2019-02-13 add copper pour GND layer to control board
    [control_board.kicad_pcb]
2019-02-13 add frequency and LFO connectors to control board
    [control_board.kicad_pcb, control_board.sch]
2019-02-13 match relative connector placement between two boards
    [connectors.sch, control_board.kicad_pcb, control_board.sch, synth_psoc.kicad_pcb]
2019-02-13 correct placement of filter connectors, and they are placed relative to the ADC connectors. This should result in mating connection between both boards.
    [connectors.sch, mcu.sch, synth_psoc.kicad_pcb]
2019-02-13 route filter connectors to op amp
    [synth_psoc.kicad_pcb]
2019-02-13 route envelope op amps
    [_saved_vca.sch, synth_psoc.kicad_pcb]
2019-02-13 route majority of ADC connections
    [synth_psoc.kicad_pcb]
2019-02-13 route JFET biasing network
    [synth_psoc.kicad_pcb]
2019-02-13 fix LFO connector schem
    [_saved_vca.sch, connectors.sch, lfo.sch, synth_psoc.kicad_pcb, synth_psoc.sch, vca.sch]
2019-02-13 route LFO
    [lfo.sch, synth_psoc.kicad_pcb]
2019-02-13 route output mixer. connector placement will probably have to change.
    [synth_psoc.kicad_pcb]
2019-02-13 place delay footprints
    [synth_psoc.kicad_pcb]
2019-02-13 route majority of delay components
    [synth_psoc.kicad_pcb]
2019-02-14 add delay connector to main board and route it.
    [connectors.sch, control_board.kicad_pcb, control_board.sch, lfo.sch, mcu.sch, mixer.sch, synth_psoc.kicad_pcb]
2019-02-14 finish routing connectors and start routing +15V
    [synth_psoc.kicad_pcb]
2019-02-14 PCBv2 release candidate. Passes DRC.
    [synth_psoc.kicad_pcb]
2019-02-20 add mounting holes to control board PCB
    [control_board.kicad_pcb]
2019-02-21 redo panel layout for new enclosure. This might not be the final version, but it'll do for now.
    [control_board.kicad_pcb]
2019-02-21 update BOM with new switch and knob prices from Aliexpress
    [BOM.xlsx]
2019-02-21 update control board with new pot placement from panel update
    [control_board.kicad_pcb]
2019-02-21 tentative edge cut on control board update
    [control_board.kicad_pcb]
2019-02-22 fix delay controls on panel artwork and control board layout
    [control_board.kicad_pcb, control_board.sch]
2019-02-22 move main synth board so that connector dimensions match between boards.
    [control_board.kicad_pcb, control_board.sch, synth_psoc.kicad_pcb]
2019-02-22 fix remaining connector placement. Routing still WIP
    [connectors.sch, lfo.sch, mcu.sch, mixer.sch, synth_psoc.kicad_pcb, synth_psoc.sch]
2019-02-22 redo control board layout. Initial version, might need more work.
    [control_board.kicad_pcb]
2019-02-23 redo connector routing with 2-row connectors
    [connectors.sch, lfo.sch, mcu.sch, mixer.sch, power.sch, synth_psoc.kicad_pcb, synth_psoc.sch, vca.sch]
2019-02-24 mostly done rerouting main board. Still some ground returns to take care of.
    [synth_psoc.kicad_pcb]
2019-02-25 add quantization again, fix connectors again, add mounting holes to main board
    [connectors.sch, control_board.kicad_pcb, control_board.sch, lfo.sch, mcu.sch, mixer.sch, power.sch, synth_psoc.kicad_pcb]
2019-02-25 reroute first connector on main board
    [control_board.sch, synth_psoc.kicad_pcb]
2019-02-25 redo second connector on main board
    [connectors.sch, lfo.sch, mcu.sch, synth_psoc.kicad_pcb, synth_psoc.sch]
2019-02-26 reroute connector board with 2-row connectors. Hold switch placement is temporary. Need to find room for this.
    [control_board.kicad_pcb, control_board.sch]
2019-02-26 increase control board size to accomodate hold switch placement. Hopefully, this is the final panel design.
    [control_board.kicad_pcb]
2019-02-26 temporary global feedback control
    [control_board.kicad_pcb, control_board.sch]
2019-02-26 fix filter pots. Dual ganged pot footprint was incorrect.
    [control_board.kicad_pcb, control_board.sch]
2019-02-26 add end stop resistors and reservoir caps to potentiometers.
    [control_board.kicad_pcb, control_board.sch]
2019-02-26 fix toggle switch footprints
    [control_board.kicad_pcb, control_board.sch]
2019-02-26 fix some missing traces on main board
    [_saved_connectors.sch, _saved_mcu.sch, control_board.sch, synth_psoc.kicad_pcb]
2019-02-26 new release candidate. Passes DRC.
    [_saved_connectors.sch, _saved_mcu.sch, connectors.sch, lfo.sch, mcu.sch, mixer.sch, power.sch, synth_psoc.kicad_pcb]
2019-02-26 fix remaining switch footprints
    [_saved_control_board.sch, control_board.kicad_pcb]
2019-02-27 add MIDI
    [_saved_connectors.sch, _saved_control_board.sch, connectors.sch, control_board.sch, lfo.sch, mcu.sch, synth_psoc.kicad_pcb]
2019-02-28 add version labels to PCB silkscreen
    [control_board.kicad_pcb, synth_psoc.kicad_pcb]
2019-02-28 arrange reference designators on main board
    [_saved_connectors.sch, mcu.sch, mixer.sch, power.sch, synth_psoc.kicad_pcb]
2019-02-28 arrange reference designators on control board
    [control_board.kicad_pcb]
2019-02-28 add missing RC feedback network for MCU delay. Probably won't end up using this, but it's there if I need it.
    [mcu.sch, synth_psoc.kicad_pcb]
2019-02-28 some schematic changes missing from previous commit. (didn't save)
    [connectors.sch, lfo.sch, mcu.sch]
2019-03-01 update BOM for v2 sample.
    [BOM.xlsx, connectors.sch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]
2019-03-06 update back panel with current rating
2019-03-11 fix frequency, PWM ADC inputs, and quantization digital inputs
    [buttons.c, interrupts.c, main.c]
2019-03-12 enable envelopes, but there are still some bugs. Doesn't always stop playing when button is released.
    [buttons.c, main.c]
2019-03-12 add USB MIDI enumeration code. This is largely copied from the Cypress code examples. Enumeration works and the device shows up in Reaper, but I haven't tested sending MIDI messages yet.
2019-03-13 initial hold/repeat code. It works but needs refinement, and it's only tested on channel 1 because I don't have enough switches.
2019-03-13 consolidate envelope and ADC update code into functions.
2019-03-13 fix envelope PWM generation by changing the envelope struct to store a pointer to the PWM value. Now the envelope PWM value ramps up correctly, although there is still an issue with reading the envel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
    [globals.h, interrupts.c, main.c]
2019-03-15 fix envelope spead ADC input mux.
    [main.c]
2019-03-19 add some reference materials on JFET VCAs
2019-03-20 MIDI note on message recognized by device.
2019-03-20 simplify code to set ADC values by making oscillator structs.
    [globals.h, interrupts.c, main.c]
2019-03-20 remove old freq and pulse_width variables which are no longer used.
    [main.c]
2019-03-21 dispatch MIDI notes to first available oscillator. Not quite working yet, but this is the correct structure.
    [buttons.c, globals.h, interrupts.c, main.c, oscillator.c]
2019-03-21 make some changes to button logic. It was incorrectly checking hold and repeat switches.
2019-03-21 fix bug in hold/repeat check in envelope calculation
    [main.c, oscillator.c]
2019-03-21 swap hold and repeat switch I/O's due to incorrect PCB layout.
2019-03-22 fix incorrect hold switch GPIO. I'll need to go through and rename everything because the numbers don't correspond to the channels. The pinout is correct, but the naming is wrong.
2019-03-22 note off MIDI messages check frequencies and only turn off the correct notes.
    [main.c, oscillator.c]
2019-03-27 fix net naming error on control board
    [control_board.sch]
2019-03-28 fix backward filter potentiometers
    [control_board.kicad_pcb, control_board.sch]
2019-03-29 increase delay time pot value. End stop resistor is still fine.
    [control_board.sch]
2019-03-29 reduce delay FB end stop resistor.
    [mixer.sch]
2019-04-01 change delay fb control to log taper.
    [control_board.sch]
2019-04-04 update VCA simulation with new bias circuit. Will probably change the entire VCA soon due to problems with this approach.
2019-04-05 WIP, delay mix control -> dual pot
    [control_board.sch]
